PwndaThePwner/Hydration/Orders&Datasheets/readme

PCB component orders and associated datasheets
