PwndaThePwner/Hydration/documents/Inventory.xlsx

Sheet: Inventory
 | INVENTORY AS OF 2/26/2021
Type | Item# | Description | # | Additional Notes |  | # used b/w 3 PCBs
MCU | ATMEGA8U2-MURCT-ND | QFN package mcu | 1 | newest mcu ordered | *** | 1
 | 556-ATMEGA32U4-AU | 32kb flash avr mcu | 2 | PCBs designed for this |  | 1
 | A000053 | Arduino Micro | 1 | prototype board | ??? | 0
PCB | FEMAVitalsMonitor | Non-flexible | 3 | - |  | *
 | FEMAVitalsMonitor | Flexible | 3 | - |  | *
 | ImpedancePulseOximeter | Non-flexible | 3 | - |  | *
 | ImpedancePulseOximeter | Flexible | 3 | - |  | *
 | BodyTempSensor | Non-flexible | 3 | - |  | *
 | BodyTempSensor | Flexible | 2 | - |  | *
LoRa | 474-Com-13909 | LoRa Radio Wireless Transceiver | 3 | RF Modules RFM69HCW Wireless Transceiver - 915MHz |  | 1
Resistors | 667-ERA-6AED1471V | 0805 1.47k ohm resistor | 5 |  |  | 1
 | 667-ERJ-6RBD5101V | 0805 5.1k ohm resistor | 5 |  |  | 2
 | 71-RCS080522R0FKEA | 0805 22 ohm resistor | 5 |  |  | 1
 | 667-ERA-6VEB1001V | 0805 1k ohm resistor | 10 |  |  | 3
 | 652-CMP0805AFX-1002L | 10k ohm resistor | 10 |  |  | 3
 | 660-HV732ATTD754J | 750k ohm resistor | 5 |  |  | 1
 | 660-RK73H2ATTD1003D | 100k ohm resistor | 20 |  |  | 6
 | 603-RT0805FRE134K7L | 4.7k ohm resistor | 20 |  |  | 7
 | 660-RS73G2ATTD4992F | 49.9k ohm resistor | 10 |  |  | 4
 | 71-RCS0805300RJNEA | 300 ohm resistor | 5 |  |  | 1
 | 667-ERJ-12SF20R0U | 2010 20 ohm resistor | 5 |  |  | 1
 | 660-RN73R2ATD2002B25 | 20k ohm resistor | 5 |  |  | 2
Capacitors | 963-UMF212B7105KGHT | 0805 1uF capacitor | 15 |  |  | 5
 | 80-C0805C226K7PACTU | 0805 22uF capacitor | 5 |  |  | 1
 | 963-HMF212B7473KGHT | 0805 47nF capacitor | 5 |  |  | 1
 | 963-UMF212B7104KGHT | 0805 0.1uF capacitor | 30 |  |  | 14
 | 963-JMF212AB7106KGHT | 0805 10uF capacitor | 20 |  |  | 9
 | 810-FA16C0G2A104JRU6 | 0.1uF capacitor | 0 | empty bag |  | *
Inductors | 810-KLZ2012AHR2R2WTD | 2.2uH 10MHz 20% inductor | 4 |  |  | 2
 | 81-LQM21DH220M70L | 22uH 220mA inductor | 4 |  |  | *
Pulse Oximeter | SEN - 15219 | SparkFun Pulse Oximeter + HRS | 1 | contains max30101 & max32664 | *** | 0
 | MAX32664GTGB+ | MAX30101 Hub | 2 | chip alone |  | 1
 | 700-MAX30101EFD+ | Pulse Oximeter | 2 | EFD+ package |  | 1
 | MAX32664GTGA+ | MAX30101 Hub | 2 | chip alone | *** | 1
 | MAX30101EFD+TCT-ND | Integrated optical sensor | 1 |  |  | *
Diodes & Rectifiers | 833-SM5817PL-TP | Diode | 5 | Standard 20V 1A |  | 1
 | 863-MBR120LSFT3G | Diode | 5 | 20V 1A |  | 1
GPS | neo-m8n-0-10 | NEO-M8 series gps module | 1 |  | ***
 | 619-28504 | Parallax GPS modules | 1
Other | B00CHTO7EC | Tactile switches | 15 |  | ???? | ?
 | 579-MCP73831T-2ACIOT | Battery Management | 4 |  |  | 1
 | 584-AD8606ARMZ-R | AD8606 Op Amp | 4 |  |  | 1
 | 604-APTD2012LSURCK | 0805 Dome Lens LED | 5 |  |  | 1
 | 621-PAM2401SCADJ | Voltage regulator | 4 | 1.0MHz Step-Up |  | ?
 | 630-HSMC-C170-T0000 | Top Mt Red LED | 4 |  |  | 1
 | 611-SK50JSMTR92LFS | Tactile switches | 4 |  |  | ?
 | 712-CONUFL001-SMD-T | uFI Connector | 5 |  |  | 1
 | 815-ABS07W32.768KD1T | 32.768kHz 3pF crystal oscillator | 4 |  |  | 1
 | X000S3Z0SH | Electrode Pads | 9 | 4 2" x 2" connected pads w/ sensor strings
 | 579-24AA32AT-I/SN | EEPROM | 4 | memory |  | 1
 | 926-LP5951MG18NOPB | Voltage regulator | 4 | 150mA TI LDO |  | ?
 | 490-UJC-HP-G-SMT-TR | USB Connectors | 4 | CUI Devices |  | ? - ordered new ones
 | 262-BME280 | BME280 | 5 | Microchip temperature sensor |  | 1
 | 604-APTR3216SECK | Orange LED | 4 | Orange water clear |  | 1
 | C845-001 P758 | Jumper Cables | 12 | prototype
 | X000ZNOCW5 | 3.5mm plug | 1 | tens replacement
 | X001KGGWZ1 | M5Stack ESP32 development kit | 1 | 4615045 for prototyping
Analog Devices Inc. | AD5933YRSZ-REEL7CT-ND | impedance analyzer | 1 | 2 listed, 1 found in bag |  | 1
 | 584-ADG849YKSZ-R7 | analogue switches | 5
 | 584-5933WYRSZR | data acquisition ADCs/DACs | 2
Textiles | 200151011034HC | Conductive Twisted Yarn | 1 | 110/34 dtex 2 ply HC LR: < 3,000 ohm/m
 | 2601151022113 | Conductive Twisted Yarn | 1 | 22/1 dtex + 113/32 PET Ag Nylon + PET LR: < 30,000 ohm/m
 | 261151044113 | Conductive Twisted Yarn | 1 | 44/12 dtex + 113/32 PET Ag Nylon + PET LR: < 30,000 ohm/m
 | 20012107818 | Conductive Twisted Yarn | 1 | 78/18 dtex Zturns Ag Nylon LR: < 25,000 ohm/m
 | 200121235364HCB | Conductive Twisted Yarn | 1 | 235/36 dtex 4 ply HCB
 | 260151022110 | Conductive Twisted Yarn | 1 | 22/7 dtex + 110 PET 3 ply Ag Nylon + PET LR: < 200,000 kohm/m
 | 260121011717 | Conductive Twisted Yarn | 1 | 117/17 dtex 2 ply +B LR: < 3,000 ohm/m
 | 20012104412 | Conductive Twisted Yarn | 1 | 44/12 dtex Zturns Ag Nylon LR: < 10,000 ohm/m

Sheet: PCB Inv. Checks
PCB Inventory Checks |  |  |  |  |  |  | Color Legend
 |  |  |  |  |  |  |  | Not in inventory
 |  |  |  |  |  |  |  | Loose in tote
MCU (FemaVitalsMonitor.kicad_pcb) |  |  |  |  |  |  |  | in MCU box | Impedance Analysis Pulse Oximeter (ImpedanceRev1.0.kicad_pcb) |  |  |  |  |  |  |  | Body Temp Sensor (BodyTempSensor.kicad_pcb
 |  |  |  |  |  |  |  | Ordered
Type | Component | # Needed | # in Inv. | Location(s) |  | Conduct? |  |  | Type | Component | # Needed | # in Inv. | Location(s) |  | Conduct? |  | Type | Component | # Needed | # in Inv. | Location(s) | ***Solid and flex pcb both soldered
Resistors | 22 Ohm 2010 Resistor | 2 | 0 | R1, R2 | x | y |  |  | Resistor | 20 Ohm 2010 Resistor | 1 | 5 | R10 | x | y |  | Resistors | 4.7k Ohm Resistor | 2 | 20 | R1, R4 | x
 | 22 Ohm 0805 Resistor | 1 | 5 | R16 | x | y |  |  |  | 300 Ohm 0805 Resistor | 1 | 5 | R11 | x | y |  | Capacitors | 0.1uF 0805 Capacitor | 2 | 30 | C1, C2 | x
 | 1k Ohm 0805 Resistor | 3 | 10 | R6, R14, R15 | x | y |  |  |  | 4.7k Ohm 0805 Resistor | 3 | 20 | R12, R13, R16 | x | y |  | Modules | BME280 - Temp Sensor | 1 | 5 | U1 | x
 | 1.47k Ohm 0805 Resistor | 1 | 5 | R9 | x | y |  |  |  | 10k Ohm 0805 Resistor | 2 | 10 | R1, R2 | x | y |  | Misc | Conn01x04 | - | - | J1
 | 4.7k Ohm 0805 Resistor | 2 | 20 | R10, R11 | x | y |  |  |  | 20k Ohm 0805 Resistor | 2 | 5 | R3, R8 | x | y
 | 5.1k Ohm 0805 Resistor | 2 | 5 | R12, R13 | x | y |  |  |  | 49.9k Ohm 0805 Resistor | 4 | 10 | R4, R5, R6, R7 | x | y
 | 10k Ohm 0805 Resistor | 1 | 10 | R5 | x | y |  |  |  | 100k Ohm 0805 Resistor | 2 | 20 | R9, R14 | x | y
 | 100k Ohm 0805 Resistor | 4 | 20 | R3, R4, R7, R8 | x | y |  |  |  | 750k Ohm 0805 Resistor | 1 | 5 | R15 | x | y
Capacitors | 0.1 uF 0805 Capacitor | 1 | 30 | C8 | x | y |  |  | Capacitors | 0.1uF 0805 Capacitor | 10 | 30 | C3-C8, C10-C13 | x | y |  | Body Temp Sensor Components List - from Drive
 | 1 uF 0805 Capacitor | 2 | 15 | C1, C6 | x | y |  |  |  | 1 uF 0805 Capacitor | 3 | 15 | C18-C20 | x | y |  | Resistors
 | 10 uF 0805 Capacitor | 5 | 20 | C2, C3, C4, C5, C7 | x | y |  |  |  | 10 uF 0805 Capacitor | 4 | 20 | C1, C14, C16, C17 | x | y |  | Name | Value | Package
LEDs/Diodes | MBR120 1A 20V Diode | 1 | 5 | D1 | x |  |  |  |  | 22 uF 0805 Capacitor | 1 | 5 | C15 | x | y |  | R1 | 4.7k Ohms | Resistor_SMD:R_0805_2012Metric_Pad1.20x1.40mm_HandSolder
 | SM5817 1A 20V Diode | 1 | 5 | D3 | x |  |  |  |  | 47 nF 0805 Capacitor | 1 | 5 | C9 | x | y |  | R4 | 4.7k Ohms | Resistor_SMD:R_0805_2012Metric_Pad1.20x1.40mm_HandSolder
 | Orange LED - Pkg:1206 | 1 | 4 | D2 | x |  |  |  | Modules | AD5933 - Impedance Analyzer | 1 | 1 | U2 | x
 | Dome Lens LED 0805 | 1 | 5 | LED1 | x |  |  |  |  | ADG849 Switch | 2 | 5 | U3, U4 | x |  |  | Capacitors
 | AlInGaP Red LED 0805 | 1 | 4 | D4 | x |  |  |  |  | AD8606 - Op Amp | 1 | 4 | U5 | x |  |  | Name | Value | Package
Modules | ATmega32U4-MU | 1 | 0 | U1 | x |  |  |  |  | MAX30101EFD+ - Pulse Oximeter | 1 | 3 | U6 | x |  |  | C1 | 0.1 uF | Capacitor_SMD:C_0805_2012Metric_Pad1.18x1.45mm_HandSolder
 | RFM69HCW LoRa Transmitter | 1 | 2 | U3 | x |  |  |  |  | PAM2401 - Voltage Regulator | 1 | 4 | U7 | x |  |  | C2 | 0.1 uF | Capacitor_SMD:C_0805_2012Metric_Pad1.18x1.45mm_HandSolder
 | uFL Coaxial Connectors | 2 | 5 | U4, U8 | x |  |  |  |  | MAX32664GTGA+T - P. Ox. Hub | 1 | 2 | U8 | ~x
 | NEO-M8 | 1 | 1 | U6 | x |  |  |  |  | LP5951MG-1.8/NOPB - Voltage Regulator | 1 | 4 | U9 | x |  |  | Modules
 | MCP73831T Battery Management | 1 | 4 | U5 | x |  |  |  | Misc | ABS07W32 - Crystal Oscillator | 1 | 4 | Y1 | x |  | non-polarized | Name | Value | Package
 | AP2112K-3.3 Voltage Regulator | 1 | 0 | U2 |  |  |  |  |  |  |  |  |  |  |  |  | U1 | BME280 | BME280
 | 24AA32A - EEPROM | 1 | 4 | U7 | x |  |  |  |  | 2.2 uH 0805 Inductor | 1 | 4 | L1 | x |  | non-polarized?
Misc | USB Connnector | 1 | 4 | J3 | x |  |  |  |  |  |  |  |  |  |  | changes dir. Of mag. Field | Misc
 | Switches | 1 | Many | SW1 | x |  |  |  |  |  |  |  |  |  |  |  | Name | Value | Package
 | 2.2 uH 0805 Inductor | 1 | 4 | L1 | x |  |  |  |  |  |  |  |  |  |  |  | J1 | Conn_01x04 | Connector_PinHeader_2.54mm:PinHeader_1x04_P2.54mm_Vertical
 | AS13AH Switch | 0 | 0 | S1
 | 8.0 MHz Resonator | 1 | 0 | Y1 | x
 |  |  |  |  |  |  |  |  | Impedance Analysis Pulse Oximeter Components List - from Drive
 | MCU PCB (FEMAVitalsMonitor.kicad_pcb) Components List - from Drive |  |  |  |  |  |  |  | Resistors
 | Resistors |  |  |  |  |  |  |  | Name | Value | Package
 | Name | Value | Package |  |  |  |  |  | R1 | 10k Ohms | Resistor_SMD:R_0805_2012Metric_Pad1.20x1.40mm_HandSolder
 | R1 | 22 Ohms | Resistor_SMD:R_2010_5025Metric_Pad1.40x2.65mm_HandSolder |  |  |  |  |  | R2 | 10k Ohms | Resistor_SMD:R_0805_2012Metric_Pad1.20x1.40mm_HandSolder
 | R2 | 22 Ohms | Resistor_SMD:R_2010_5025Metric_Pad1.40x2.65mm_HandSolder |  |  |  |  |  | R3 | 20k Ohms | Resistor_SMD:R_0805_2012Metric_Pad1.20x1.40mm_HandSolder
 | R3 | 100k Ohms | Resistor_SMD:R_0805_2012Metric_Pad1.20x1.40mm_HandSolder |  |  |  |  |  | R4 | 49.9k Ohms | Resistor_SMD:R_0805_2012Metric_Pad1.20x1.40mm_HandSolder
 | R4 | 100k Ohms | Resistor_SMD:R_0805_2012Metric_Pad1.20x1.40mm_HandSolder |  |  |  |  |  | R5 | 49.9k Ohms | Resistor_SMD:R_0805_2012Metric_Pad1.20x1.40mm_HandSolder
 | R5 | 10k Ohms | Resistor_SMD:R_0805_2012Metric_Pad1.20x1.40mm_HandSolder |  |  |  |  |  | R6 | 49.9k Ohms | Resistor_SMD:R_0805_2012Metric_Pad1.20x1.40mm_HandSolder
 | R6 | 1k Ohms | Resistor_SMD:R_0805_2012Metric_Pad1.20x1.40mm_HandSolder |  |  |  |  |  | R7 | 49.9k Ohms | Resistor_SMD:R_0805_2012Metric_Pad1.20x1.40mm_HandSolder
 | R7 | 100k Ohms | Resistor_SMD:R_0805_2012Metric_Pad1.20x1.40mm_HandSolder |  |  |  |  |  | R8 | 20k Ohms | Resistor_SMD:R_0805_2012Metric_Pad1.20x1.40mm_HandSolder
 | R8 | 100k Ohms | Resistor_SMD:R_0805_2012Metric_Pad1.20x1.40mm_HandSolder |  |  |  |  |  | R9 | 100k Ohms | Resistor_SMD:R_0805_2012Metric_Pad1.20x1.40mm_HandSolder
 | R9 | 1.47k Ohms | Resistor_SMD:R_0805_2012Metric_Pad1.20x1.40mm_HandSolder |  |  |  |  |  | R10 | 20 Ohms | Resistor_SMD:R_2010_5025Metric_Pad1.40x2.65mm_HandSolder
 | R10 | 4.7k Ohms | Resistor_SMD:R_0805_2012Metric_Pad1.20x1.40mm_HandSolder |  |  |  |  |  | R11 | 300 Ohms | Resistor_SMD:R_0805_2012Metric_Pad1.20x1.40mm_HandSolder
 | R11 | 4.7k Ohms | Resistor_SMD:R_0805_2012Metric_Pad1.20x1.40mm_HandSolder |  |  |  |  |  | R12 | 4.7k Ohms | Resistor_SMD:R_0805_2012Metric_Pad1.20x1.40mm_HandSolder
 | R12 | 5.1k Ohms | Resistor_SMD:R_0805_2012Metric_Pad1.20x1.40mm_HandSolder |  |  |  |  |  | R13 | 4.7k Ohms | Resistor_SMD:R_0805_2012Metric_Pad1.20x1.40mm_HandSolder
 | R13 | 5.1k Ohms | Resistor_SMD:R_0805_2012Metric_Pad1.20x1.40mm_HandSolder |  |  |  |  |  | R14 | 100k Ohms | Resistor_SMD:R_0805_2012Metric_Pad1.20x1.40mm_HandSolder
 | R14 | 1k Ohms | Resistor_SMD:R_0805_2012Metric_Pad1.20x1.40mm_HandSolder |  |  |  |  |  | R15 | 750k Ohms | Resistor_SMD:R_0805_2012Metric_Pad1.20x1.40mm_HandSolder
 | R15 | 1k Ohms | Resistor_SMD:R_0805_2012Metric_Pad1.20x1.40mm_HandSolder |  |  |  |  |  | R16 | 4.7k Ohms | Resistor_SMD:R_0805_2012Metric_Pad1.20x1.40mm_HandSolder
 | R16 | 22 Ohms | Resistor_SMD:R_0805_2012Metric_Pad1.20x1.40mm_HandSolder
 |  |  |  |  |  |  |  |  | Capacitors
 | Capacitors |  |  |  |  |  |  |  | Name | Value | Packages
 | Name | Value | Package |  |  |  |  |  | C1 | 10 uF | Capacitor_SMD:C_0805_2012Metric_Pad1.18x1.45mm_HandSolder
 | C1 | 1 uF | Capacitor_SMD:C_0805_2012Metric_Pad1.18x1.45mm_HandSolder |  |  |  |  |  | C3 | 0.1 uF | Capacitor_SMD:C_0805_2012Metric_Pad1.18x1.45mm_HandSolder
 | C2 | 10 uF | Capacitor_SMD:C_0805_2012Metric_Pad1.18x1.45mm_HandSolder |  |  |  |  |  | C4 | 0.1 uF | Capacitor_SMD:C_0805_2012Metric_Pad1.18x1.45mm_HandSolder
 | C3 | 10 uF | Capacitor_SMD:C_0805_2012Metric_Pad1.18x1.45mm_HandSolder |  |  |  |  |  | C5 | 0.1 uF | Capacitor_SMD:C_0805_2012Metric_Pad1.18x1.45mm_HandSolder
 | C4 | 10 uF | Capacitor_SMD:C_0805_2012Metric_Pad1.18x1.45mm_HandSolder |  |  |  |  |  | C6 | 0.1 uF | Capacitor_SMD:C_0805_2012Metric_Pad1.18x1.45mm_HandSolder
 | C5 | 10 uF | Capacitor_SMD:C_0805_2012Metric_Pad1.18x1.45mm_HandSolder |  |  |  |  |  | C7 | 0.1 uF | Capacitor_SMD:C_0805_2012Metric_Pad1.18x1.45mm_HandSolder
 | C6 | 1 uF | Capacitor_SMD:C_0805_2012Metric_Pad1.18x1.45mm_HandSolder |  |  |  |  |  | C8 | 0.1 uF | Capacitor_SMD:C_0805_2012Metric_Pad1.18x1.45mm_HandSolder
 | C7 | 10 uF | Capacitor_SMD:C_0805_2012Metric_Pad1.18x1.45mm_HandSolder |  |  |  |  |  | C9 | 47 nF | Capacitor_SMD:C_0805_2012Metric_Pad1.18x1.45mm_HandSolder
 | C8 | 0.1 uF | Capacitor_SMD:C_0805_2012Metric_Pad1.18x1.45mm_HandSolder |  |  |  |  |  | C10 | 0.1 uF | Capacitor_SMD:C_0805_2012Metric_Pad1.18x1.45mm_HandSolder
 |  |  |  |  |  |  |  |  | C11 | 0.1 uF | Capacitor_SMD:C_0805_2012Metric_Pad1.18x1.45mm_HandSolder
 | Diodes |  |  |  |  |  |  |  | C12 | 0.1 uF | Capacitor_SMD:C_0805_2012Metric_Pad1.18x1.45mm_HandSolder
 | Name | Value | Package |  |  |  |  |  | C13 | 0.1 uF | Capacitor_SMD:C_0805_2012Metric_Pad1.18x1.45mm_HandSolder
 | D1 | MBR120 | Diode_SMD:D_SOD-123F |  |  |  |  |  | C14 | 10 uF | Capacitor_SMD:C_0805_2012Metric_Pad1.18x1.45mm_HandSolder
 | D2 | LED | LED_SMD:LED_1206_3216Metric_Pad1.42x1.75mm_HandSolder |  |  |  |  |  | C15 | 22 uF | Capacitor_SMD:C_0805_2012Metric_Pad1.18x1.45mm_HandSolder
 | D3 | SM5817PL-TP | SOD3716X120N |  |  |  |  |  | C16 | 10 uF | Capacitor_SMD:C_0805_2012Metric_Pad1.18x1.45mm_HandSolder
 | D4 | FIX | LED_SMD:LED_0805_2012Metric_Pad1.15x1.40mm_HandSolder |  |  |  |  |  | C17 | 10 uF | Capacitor_SMD:C_0805_2012Metric_Pad1.18x1.45mm_HandSolder
 | LED1 | APTD2012LSURCK | LEDM2012X120N |  |  |  |  |  | C18 | 1.0 uF | Capacitor_SMD:C_0805_2012Metric_Pad1.18x1.45mm_HandSolder
 |  |  |  |  |  |  |  |  | C19 | 1.0 uF | Capacitor_SMD:C_0805_2012Metric_Pad1.18x1.45mm_HandSolder
 | Modules |  |  |  |  |  |  |  | C20 | 1.0 uF | Capacitor_SMD:C_0805_2012Metric_Pad1.18x1.45mm_HandSolder
 | Name | Value | Package
 | U1 | ATmega32U4-MU | Package_DFN_QFN:QFN-44-1EP_7x7mm_P0.5mm_EP5.2x5.2mm |  |  |  |  |  | Modules
 | U2 | AP2112K-3.3 | Package_TO_SOT_SMD:SOT-23-5 |  |  |  |  |  | Name | Value | Packages
 | U3 | RFM69HCW | RFM69HCW |  |  |  |  |  | U2 | AD5933 | Package_SO:SSOP-16_5.3x6.2mm_P0.65mm
 | U4 | uFL | Connector_Coaxial:U.FL_Hirose_U.FL-R-SMT-1_Vertical |  |  |  |  |  | U3 | ADG849 | ADG849
 | U5 | MCP73831-2-OT | Package_TO_SOT_SMD:SOT-23-5 |  |  |  |  |  | U4 | ADG849 | ADG849
 | U6 | NEO-M8 | NEO-M8 |  |  |  |  |  | U5 | AD8606 | Package_SO:MSOP-8_3x3mm_P0.65mm
 | U7 | 24AA32A | Package_SO:SOIJ-8_5.3x5.3mm_P1.27mm |  |  |  |  |  | U6 | MAX30101EFD | SamacSys_Parts:14-LEAD-OESIP
 | U8 | uFL | Connector_Coaxial:U.FL_Hirose_U.FL-R-SMT-1_Vertical |  |  |  |  |  | U7 | PAM2401 | Package_SO:MSOP-8_3x3mm_P0.65mm
 |  |  |  |  |  |  |  |  | U8 | MAX32664GTGA+T | MAX32664GTGA+T
 | Misc |  |  |  |  |  |  |  | U9 | LP5951MG-1.8/NOPB | Package_TO_SOT_SMD:SOT-353_SC-70-5_Handsoldering
 | Name | Value | Package
 | J1 | Battery | Connector_PinHeader_2.54mm:PinHeader_1x02_P2.54mm_Vertical |  |  |  |  |  | Misc
 | J2 | Conn_01x08 | Connector_PinHeader_2.54mm:PinHeader_1x08_P2.54mm_Vertical |  |  |  |  |  | Name | Value | Packages
 | J3 | USB_C_Receptacle_USB2.0 | Connector_USB:USB_C_Receptacle_GCT_USB4085 |  |  |  |  |  | J1 | Conn_01x08 | Connector_PinHeader_2.54mm:PinHeader_1x08_P2.54mm_Vertical
 | Y1 | 8MHz | SamacSys_Parts:AWSCR800CELBC10T3 |  |  |  |  |  | J2 | Electrode + | Connector_PinHeader_2.54mm:PinHeader_1x02_P2.54mm_Vertical
 | SW1 | SW_DIP_x01 | Button_Switch_THT:SW_PUSH_6mm_H7.3mm |  |  |  |  |  | J3 | Electrode - | Connector_PinHeader_2.54mm:PinHeader_1x02_P2.54mm_Vertical
 | S1 | AS11AH | AS11AH |  |  |  |  |  | Y1 | ABS07W-32.768kHz-D-1-T | ABS07AIG32768kHz71T
 | L1 | 22 uH | Inductor_SMD:L_0805_2012Metric_Pad1.15x1.40mm_HandSolder |  |  |  |  |  | L1 | 2.2 uH | Inductor_SMD:L_0805_2012Metric_Pad1.15x1.40mm_HandSolder

Sheet: 4-28 Inv. Etc.
Item | Quantity
FVM Rigid PCB | 3
IAPO Rigid PCB | 3
BTS Rigid PCB | 2
BTS Rigid PCB (assembled) | 1
FVM Flex PCB | 2
FVM Flex PCB (in progress) | 1
IAPO Flex PCB | 2
IAPO Flex PCB (assembled) | 1
BTS Flex PCB | 1
BTS Flex PCB (assembled) | 1

Sheet: 4-28 PCB Inv.
PCB Inventory Checks |  |  |  |  |  | Color Legend
 |  |  |  |  |  |  | Ordered
 |  |  |  |  |  |  | Not in inventory
FVM (FemaVitalsMonitor.kicad_pcb) |  |  |  |  |  |  |  | IAPO (ImpedanceRev1.0.kicad_pcb) |  |  |  |  | BTS (BodyTempSensor.kicad_pcb
Type | Component | # Needed | # in Inv. | Location(s) |  |  |  | Type | Component | # Needed | # in Inv. | Location(s) | Type | Component | # Needed | # in Inv. | Location(s)
Resistors | 22 Ohm 2010 Resistor | 2 | 3 | R1, R2 | x |  |  | Resistor | 20 Ohm 2010 Resistor | 1 | 4 | R10 | Resistors | 4.7k Ohm Resistor | 2 | 11 | R1, R4
 | 22 Ohm 0805 Resistor | 1 | 4 | R16 | x |  |  |  | 300 Ohm 0805 Resistor | 1 | 4 | R11 | Capacitors | 0.1uF 0805 Capacitor | 2 | 14 | C1, C2
 | 1k Ohm 0805 Resistor | 3 | 7 | R6, R14, R15 | x |  |  |  | 4.7k Ohm 0805 Resistor | 3 | 11 | R12, R13, R16 | Modules | BME280 - Temp Sensor | 1 | 3 | U1
 | 1.47k Ohm 0805 Resistor | 1 | 4 | R9 | x |  |  |  | 10k Ohm 0805 Resistor | 2 | 7 | R1, R2 | Misc | Conn01x04 | - | - | J1
 | 4.7k Ohm 0805 Resistor | 2 | 11 | R10, R11 | x |  |  |  | 20k Ohm 0805 Resistor | 2 | 3 | R3, R8
 | 5.1k Ohm 0805 Resistor | 2 | 3 | R12, R13 | x |  |  |  | 49.9k Ohm 0805 Resistor | 4 | 5 | R4, R5, R6, R7
 | 10k Ohm 0805 Resistor | 1 | 7 | R5 | x |  |  |  | 100k Ohm 0805 Resistor | 2 | 12 | R9, R14
 | 100k Ohm 0805 Resistor | 4 | 12 | R3, R4, R7, R8 | x |  |  |  | 750k Ohm 0805 Resistor | 1 | 4 | R15
Capacitors | 0.1 uF 0805 Capacitor | 1 | 14 | C8 | X |  |  | Capacitors | 0.1uF 0805 Capacitor | 10 | 14 | C3-C8, C10-C13 | Body Temp Sensor Components List - from Drive
 | 1 uF 0805 Capacitor | 2 | 9 | C1, C6 | x |  |  |  | 1 uF 0805 Capacitor | 3 | 9 | C18-C20 | Resistors
 | 10 uF 0805 Capacitor | 5 | 11 | C2, C3, C4, C5, C7 | x |  |  |  | 10 uF 0805 Capacitor | 4 | 11 | C1, C14, C16, C17 | Name | Value | Package
LEDs/Diodes | MBR120 1A 20V Diode | 1 | 4 | D1 | X |  |  |  | 22 uF 0805 Capacitor | 1 | 4 | C15 | R1 | 4.7k Ohms | Resistor_SMD:R_0805_2012Metric_Pad1.20x1.40mm_HandSolder
 | SM5817 1A 20V Diode | 1 | 4 | D3 |  |  |  |  | 47 nF 0805 Capacitor | 1 | 4 | C9 | R4 | 4.7k Ohms | Resistor_SMD:R_0805_2012Metric_Pad1.20x1.40mm_HandSolder
 | Orange LED - Pkg:1206 | 1 | 3 | D2 | X |  |  | Modules | AD5933 - Impedance Analyzer | 1 | 2 | U2
 | Dome Lens LED 0805 | 1 | 4 | LED1 |  |  |  |  | ADG849 Switch | 2 | 1 | U3, U4 | Capacitors
 | AlInGaP Red LED 0805 | 1 | 3 | D4 |  |  |  |  | AD8606 - Op Amp | 1 | 2 | U5 | Name | Value | Package
Modules | ATmega32U4-MU | 1 | 2 | U1 |  |  |  |  | MAX30101EFD+ - Pulse Oximeter | 1 | 0 | U6 | C1 | 0.1 uF | Capacitor_SMD:C_0805_2012Metric_Pad1.18x1.45mm_HandSolder
 | RFM69HCW LoRa Transmitter | 1 | 3 | U3 | x |  |  |  | PAM2401 - Voltage Regulator | 1 | 4 | U7 | C2 | 0.1 uF | Capacitor_SMD:C_0805_2012Metric_Pad1.18x1.45mm_HandSolder
 | uFL Coaxial Connectors | 2 | 3 | U4, U8 | x |  |  |  | MAX32664GTGA+T - P. Ox. Hub | 1 | 1 | U8
 | NEO-M8 | 1 | 0 | U6 |  |  |  |  | LP5951MG-1.8/NOPB - Voltage Regulator | 1 | 3 | U9 | Modules
 | MCP73831T Battery Management | 1 | 3 | U5 |  |  |  | Misc | ABS07W32 - Crystal Oscillator | 1 | 3 | Y1 | Name | Value | Package
 | AP2112K-3.3 Voltage Regulator | 1 | 0 | U2 |  |  |  |  |  |  |  |  | U1 | BME280 | BME280
 | 24AA32A - EEPROM | 1 | 3 | U7 |  |  |  |  | 2.2 uH 0805 Inductor | 1 | 1 | L1
Misc | USB Connnector | 1 | 2 | J3 |  |  |  |  |  |  |  |  | Misc
 | Switches | 1 | Many | SW1 |  |  |  |  |  |  |  |  | Name | Value | Package
 | 2.2 uH 0805 Inductor | 1 | 1 | L1 | x |  |  |  |  |  |  |  | J1 | Conn_01x04 | Connector_PinHeader_2.54mm:PinHeader_1x04_P2.54mm_Vertical
 | AS11AH Switch | 1 | 2 | S1
 | 8.0 MHz Resonator | 1 | 4 | Y1 | x
 |  |  |  |  |  |  |  | Impedance Analysis Pulse Oximeter Components List - from Drive
 | MCU PCB (FEMAVitalsMonitor.kicad_pcb) Components List - from Drive |  |  |  |  |  |  | Resistors
 | Resistors |  |  |  |  |  |  | Name | Value | Package
 | Name | Value | Package |  |  |  |  | R1 | 10k Ohms | Resistor_SMD:R_0805_2012Metric_Pad1.20x1.40mm_HandSolder
 | R1 | 22 Ohms | Resistor_SMD:R_2010_5025Metric_Pad1.40x2.65mm_HandSolder |  |  |  |  | R2 | 10k Ohms | Resistor_SMD:R_0805_2012Metric_Pad1.20x1.40mm_HandSolder
 | R2 | 22 Ohms | Resistor_SMD:R_2010_5025Metric_Pad1.40x2.65mm_HandSolder |  |  |  |  | R3 | 20k Ohms | Resistor_SMD:R_0805_2012Metric_Pad1.20x1.40mm_HandSolder
 | R3 | 100k Ohms | Resistor_SMD:R_0805_2012Metric_Pad1.20x1.40mm_HandSolder |  |  |  |  | R4 | 49.9k Ohms | Resistor_SMD:R_0805_2012Metric_Pad1.20x1.40mm_HandSolder
 | R4 | 100k Ohms | Resistor_SMD:R_0805_2012Metric_Pad1.20x1.40mm_HandSolder |  |  |  |  | R5 | 49.9k Ohms | Resistor_SMD:R_0805_2012Metric_Pad1.20x1.40mm_HandSolder
 | R5 | 10k Ohms | Resistor_SMD:R_0805_2012Metric_Pad1.20x1.40mm_HandSolder |  |  |  |  | R6 | 49.9k Ohms | Resistor_SMD:R_0805_2012Metric_Pad1.20x1.40mm_HandSolder
 | R6 | 1k Ohms | Resistor_SMD:R_0805_2012Metric_Pad1.20x1.40mm_HandSolder |  |  |  |  | R7 | 49.9k Ohms | Resistor_SMD:R_0805_2012Metric_Pad1.20x1.40mm_HandSolder
 | R7 | 100k Ohms | Resistor_SMD:R_0805_2012Metric_Pad1.20x1.40mm_HandSolder |  |  |  |  | R8 | 20k Ohms | Resistor_SMD:R_0805_2012Metric_Pad1.20x1.40mm_HandSolder
 | R8 | 100k Ohms | Resistor_SMD:R_0805_2012Metric_Pad1.20x1.40mm_HandSolder |  |  |  |  | R9 | 100k Ohms | Resistor_SMD:R_0805_2012Metric_Pad1.20x1.40mm_HandSolder
 | R9 | 1.47k Ohms | Resistor_SMD:R_0805_2012Metric_Pad1.20x1.40mm_HandSolder |  |  |  |  | R10 | 20 Ohms | Resistor_SMD:R_2010_5025Metric_Pad1.40x2.65mm_HandSolder
 | R10 | 4.7k Ohms | Resistor_SMD:R_0805_2012Metric_Pad1.20x1.40mm_HandSolder |  |  |  |  | R11 | 300 Ohms | Resistor_SMD:R_0805_2012Metric_Pad1.20x1.40mm_HandSolder
 | R11 | 4.7k Ohms | Resistor_SMD:R_0805_2012Metric_Pad1.20x1.40mm_HandSolder |  |  |  |  | R12 | 4.7k Ohms | Resistor_SMD:R_0805_2012Metric_Pad1.20x1.40mm_HandSolder
 | R12 | 5.1k Ohms | Resistor_SMD:R_0805_2012Metric_Pad1.20x1.40mm_HandSolder |  |  |  |  | R13 | 4.7k Ohms | Resistor_SMD:R_0805_2012Metric_Pad1.20x1.40mm_HandSolder
 | R13 | 5.1k Ohms | Resistor_SMD:R_0805_2012Metric_Pad1.20x1.40mm_HandSolder |  |  |  |  | R14 | 100k Ohms | Resistor_SMD:R_0805_2012Metric_Pad1.20x1.40mm_HandSolder
 | R14 | 1k Ohms | Resistor_SMD:R_0805_2012Metric_Pad1.20x1.40mm_HandSolder |  |  |  |  | R15 | 750k Ohms | Resistor_SMD:R_0805_2012Metric_Pad1.20x1.40mm_HandSolder
 | R15 | 1k Ohms | Resistor_SMD:R_0805_2012Metric_Pad1.20x1.40mm_HandSolder |  |  |  |  | R16 | 4.7k Ohms | Resistor_SMD:R_0805_2012Metric_Pad1.20x1.40mm_HandSolder
 | R16 | 22 Ohms | Resistor_SMD:R_0805_2012Metric_Pad1.20x1.40mm_HandSolder
 |  |  |  |  |  |  |  | Capacitors
 | Capacitors |  |  |  |  |  |  | Name | Value | Packages
 | Name | Value | Package |  |  |  |  | C1 | 10 uF | Capacitor_SMD:C_0805_2012Metric_Pad1.18x1.45mm_HandSolder
 | C1 | 1 uF | Capacitor_SMD:C_0805_2012Metric_Pad1.18x1.45mm_HandSolder |  |  |  |  | C3 | 0.1 uF | Capacitor_SMD:C_0805_2012Metric_Pad1.18x1.45mm_HandSolder
 | C2 | 10 uF | Capacitor_SMD:C_0805_2012Metric_Pad1.18x1.45mm_HandSolder |  |  |  |  | C4 | 0.1 uF | Capacitor_SMD:C_0805_2012Metric_Pad1.18x1.45mm_HandSolder
 | C3 | 10 uF | Capacitor_SMD:C_0805_2012Metric_Pad1.18x1.45mm_HandSolder |  |  |  |  | C5 | 0.1 uF | Capacitor_SMD:C_0805_2012Metric_Pad1.18x1.45mm_HandSolder
 | C4 | 10 uF | Capacitor_SMD:C_0805_2012Metric_Pad1.18x1.45mm_HandSolder |  |  |  |  | C6 | 0.1 uF | Capacitor_SMD:C_0805_2012Metric_Pad1.18x1.45mm_HandSolder
 | C5 | 10 uF | Capacitor_SMD:C_0805_2012Metric_Pad1.18x1.45mm_HandSolder |  |  |  |  | C7 | 0.1 uF | Capacitor_SMD:C_0805_2012Metric_Pad1.18x1.45mm_HandSolder
 | C6 | 1 uF | Capacitor_SMD:C_0805_2012Metric_Pad1.18x1.45mm_HandSolder |  |  |  |  | C8 | 0.1 uF | Capacitor_SMD:C_0805_2012Metric_Pad1.18x1.45mm_HandSolder
 | C7 | 10 uF | Capacitor_SMD:C_0805_2012Metric_Pad1.18x1.45mm_HandSolder |  |  |  |  | C9 | 47 nF | Capacitor_SMD:C_0805_2012Metric_Pad1.18x1.45mm_HandSolder
 | C8 | 0.1 uF | Capacitor_SMD:C_0805_2012Metric_Pad1.18x1.45mm_HandSolder |  |  |  |  | C10 | 0.1 uF | Capacitor_SMD:C_0805_2012Metric_Pad1.18x1.45mm_HandSolder
 |  |  |  |  |  |  |  | C11 | 0.1 uF | Capacitor_SMD:C_0805_2012Metric_Pad1.18x1.45mm_HandSolder
 | Diodes |  |  |  |  |  |  | C12 | 0.1 uF | Capacitor_SMD:C_0805_2012Metric_Pad1.18x1.45mm_HandSolder
 | Name | Value | Package |  |  |  |  | C13 | 0.1 uF | Capacitor_SMD:C_0805_2012Metric_Pad1.18x1.45mm_HandSolder
 | D1 | MBR120 | Diode_SMD:D_SOD-123F |  |  |  |  | C14 | 10 uF | Capacitor_SMD:C_0805_2012Metric_Pad1.18x1.45mm_HandSolder
 | D2 | LED | LED_SMD:LED_1206_3216Metric_Pad1.42x1.75mm_HandSolder |  |  |  |  | C15 | 22 uF | Capacitor_SMD:C_0805_2012Metric_Pad1.18x1.45mm_HandSolder
 | D3 | SM5817PL-TP | SOD3716X120N |  |  |  |  | C16 | 10 uF | Capacitor_SMD:C_0805_2012Metric_Pad1.18x1.45mm_HandSolder
 | D4 | FIX | LED_SMD:LED_0805_2012Metric_Pad1.15x1.40mm_HandSolder |  |  |  |  | C17 | 10 uF | Capacitor_SMD:C_0805_2012Metric_Pad1.18x1.45mm_HandSolder
 | LED1 | APTD2012LSURCK | LEDM2012X120N |  |  |  |  | C18 | 1.0 uF | Capacitor_SMD:C_0805_2012Metric_Pad1.18x1.45mm_HandSolder
 |  |  |  |  |  |  |  | C19 | 1.0 uF | Capacitor_SMD:C_0805_2012Metric_Pad1.18x1.45mm_HandSolder
 | Modules |  |  |  |  |  |  | C20 | 1.0 uF | Capacitor_SMD:C_0805_2012Metric_Pad1.18x1.45mm_HandSolder
 | Name | Value | Package
 | U1 | ATmega32U4-MU | Package_DFN_QFN:QFN-44-1EP_7x7mm_P0.5mm_EP5.2x5.2mm |  |  |  |  | Modules
 | U2 | AP2112K-3.3 | Package_TO_SOT_SMD:SOT-23-5 |  |  |  |  | Name | Value | Packages
 | U3 | RFM69HCW | RFM69HCW |  |  |  |  | U2 | AD5933 | Package_SO:SSOP-16_5.3x6.2mm_P0.65mm
 | U4 | uFL | Connector_Coaxial:U.FL_Hirose_U.FL-R-SMT-1_Vertical |  |  |  |  | U3 | ADG849 | ADG849
 | U5 | MCP73831-2-OT | Package_TO_SOT_SMD:SOT-23-5 |  |  |  |  | U4 | ADG849 | ADG849
 | U6 | NEO-M8 | NEO-M8 |  |  |  |  | U5 | AD8606 | Package_SO:MSOP-8_3x3mm_P0.65mm
 | U7 | 24AA32A | Package_SO:SOIJ-8_5.3x5.3mm_P1.27mm |  |  |  |  | U6 | MAX30101EFD | SamacSys_Parts:14-LEAD-OESIP
 | U8 | uFL | Connector_Coaxial:U.FL_Hirose_U.FL-R-SMT-1_Vertical |  |  |  |  | U7 | PAM2401 | Package_SO:MSOP-8_3x3mm_P0.65mm
 |  |  |  |  |  |  |  | U8 | MAX32664GTGA+T | MAX32664GTGA+T
 | Misc |  |  |  |  |  |  | U9 | LP5951MG-1.8/NOPB | Package_TO_SOT_SMD:SOT-353_SC-70-5_Handsoldering
 | Name | Value | Package
 | J1 | Battery | Connector_PinHeader_2.54mm:PinHeader_1x02_P2.54mm_Vertical |  |  |  |  | Misc
 | J2 | Conn_01x08 | Connector_PinHeader_2.54mm:PinHeader_1x08_P2.54mm_Vertical |  |  |  |  | Name | Value | Packages
 | J3 | USB_C_Receptacle_USB2.0 | Connector_USB:USB_C_Receptacle_GCT_USB4085 |  |  |  |  | J1 | Conn_01x08 | Connector_PinHeader_2.54mm:PinHeader_1x08_P2.54mm_Vertical
 | Y1 | 8MHz | SamacSys_Parts:AWSCR800CELBC10T3 |  |  |  |  | J2 | Electrode + | Connector_PinHeader_2.54mm:PinHeader_1x02_P2.54mm_Vertical
 | SW1 | SW_DIP_x01 | Button_Switch_THT:SW_PUSH_6mm_H7.3mm |  |  |  |  | J3 | Electrode - | Connector_PinHeader_2.54mm:PinHeader_1x02_P2.54mm_Vertical
 | S1 | AS11AH | AS11AH |  |  |  |  | Y1 | ABS07W-32.768kHz-D-1-T | ABS07AIG32768kHz71T
 | L1 | 22 uH | Inductor_SMD:L_0805_2012Metric_Pad1.15x1.40mm_HandSolder |  |  |  |  | L1 | 2.2 uH | Inductor_SMD:L_0805_2012Metric_Pad1.15x1.40mm_HandSolder

Sheet: 4-30 Order Count
Item | FVM | IAPO | BTS | # Needed/Assembled System | Total Needed for 3 systems | # Needed for first system | # in Inv. (4/30) | # to order (4/30)
Resistors
20 Ohm 2010 Resistor | 0 | 1 | 0 | 1 | 3 | 0 | 4 | 2
22 Ohm 2010 Resistor | 2 | 0 | 0 | 2 | 6 | 0 | 3 | 6
22 Ohm 0805 Resistor | 1 | 0 | 0 | 1 | 3 | 0 | 4 | 2
300 Ohm 0805 Resistor | 0 | 1 | 0 | 1 | 3 | 0 | 4 | 2
1k Ohm 0805 Resistor | 3 | 0 | 0 | 3 | 9 | 0 | 7 | 5
1.47k Ohm 0805 Resistor | 1 | 0 | 0 | 1 | 3 | 0 | 4 | 2
4.7k Ohm 0805 Resistor | 2 | 3 | 2 | 7 | 21 | 0 | 11 | 13
5.1k Ohm 0805 Resistor | 2 | 0 | 0 | 2 | 6 | 0 | 3 | 6
10k Ohm 0805 Resistor | 1 | 2 | 0 | 3 | 9 | 0 | 7 | 5
20k Ohm 0805 Resistor | 0 | 2 | 0 | 2 | 6 | 0 | 3 | 6
49.9k Ohm 0805 Resistor | 0 | 4 | 0 | 4 | 12 | 0 | 5 | 10
100k Ohm 0805 Resistor | 4 | 2 | 0 | 6 | 18 | 0 | 12 | 9
750k Ohm 0805 Resistor | 0 | 1 | 0 | 1 | 3 | 0 | 4 | 2
Capacitors
0.1uF 0805 Capacitor | 1 | 10 | 2 | 13 | 39 | 0 | 14 | 28
1 uF 0805 Capacitor | 2 | 3 | 0 | 5 | 15 | 0 | 9 | 9
10 uF 0805 Capacitor | 5 | 4 | 0 | 9 | 27 | 0 | 11 | 19
22 uF 0805 Capacitor | 0 | 1 | 0 | 1 | 3 | 0 | 4 | 2
47 nF 0805 Capacitor | 0 | 1 | 0 | 1 | 3 | 0 | 4 | 2
LEDs/Diodes
MBR120 1A 20V Diode | 1 | 0 | 0 | 1 | 3 | 0 | 4 | 2
SM5817 1A 20V Diode | 1 | 0 | 0 | 1 | 3 | 0 | 4 | 2
Orange LED - Pkg:1206 | 1 | 0 | 0 | 1 | 3 | 0 | 3 | 3
Dome Lens LED 0805 | 1 | 0 | 0 | 1 | 3 | 0 | 4 | 2
AlInGaP Red LED 0805 | 1 | 0 | 0 | 1 | 3 | 0 | 3 | 3
Modules
ATmega32U4-MU | 1 | 0 | 0 | 1 | 3 | 0 | 2 | 4
RFM69HCW LoRa Transmitter | 1 | 0 | 0 | 1 | 3 | 1 | 0 | 7
uFL Coaxial Connectors | 2 | 0 | 0 | 2 | 6 | 0 | 3 | 6
NEO-M8 | 1 | 0 | 0 | 1 | 3 | 1 | 0 | 7
MCP73831T Battery Management | 1 | 0 | 0 | 1 | 3 | 0 | 3 | 3
AP2112K-3.3 Voltage Regulator | 1 | 0 | 0 | 1 | 3 | 0 | 0 | 6
24AA32A - EEPROM | 1 | 0 | 0 | 1 | 3 | 0 | 3 | 3
AD5933 - Impedance Analyzer | 0 | 1 | 0 | 1 | 3 | 0 | 2 | 4
ADG849 Switch | 0 | 2 | 0 | 2 | 6 | 0 | 1 | 8
AD8606 - Op Amp | 0 | 1 | 0 | 1 | 3 | 0 | 2 | 4
MAX30101EFD+ - Pulse Oximeter | 0 | 1 | 0 | 1 | 3 | 1 | 0 | 7
PAM2401 - Voltage Regulator | 0 | 1 | 0 | 1 | 3 | 0 | 4 | 2
MAX32664GTGA+T - P. Ox. Hub | 0 | 1 | 0 | 1 | 3 | 0 | 1 | 5
LP5951MG-1.8/NOPB - Voltage Regulator | 0 | 1 | 0 | 1 | 3 | 0 | 3 | 3
BME280 - Temp Sensor | 0 | 0 | 1 | 1 | 3 | 0 | 3 | 3
Misc.
USB Connnector | 1 | 0 | 0 | 1 | 3 | 0 | 2 | 4
Switches | 1 | 0 | 0 | 1 | 3 | 0 | Many | 0
2.2 uH 0805 Inductor | 1 | 1 | 0 | 2 | 6 | 0 | 1 | 8
AS11AH Switch | 1 | 0 | 0 | 1 | 3 | 0 | 2 | 4
8.0 MHz Resonator | 1 | 0 | 0 | 1 | 3 | 0 | 4 | 2
ABS07W32 - Crystal Oscillator | 0 | 1 | 0 | 1 | 3 | 0 | 3 | 3

Sheet: Sheet1
RECEIVING
DATE | ITEM | QUANTITY
2021-05-12 | 621-AP7365-WG-7 | 7
