PwndaThePwner/Hydration/documents/Soldering_Rework.docx

SOLDERING REWORK

FVM

- Neo-M8

IAPO

- U8: MAX32664GTGA+T - P. Ox. Hub
- U4/U3: ADG849 Switch
