PwndaThePwner/Hydration/FEMAVitalsMonitor/BodyTempSensor/BodyTempSensor.kicad_pcb

## KiCad design FEMAVitalsMonitor/BodyTempSensor/BodyTempSensor.kicad_pcb (2021-05-06)

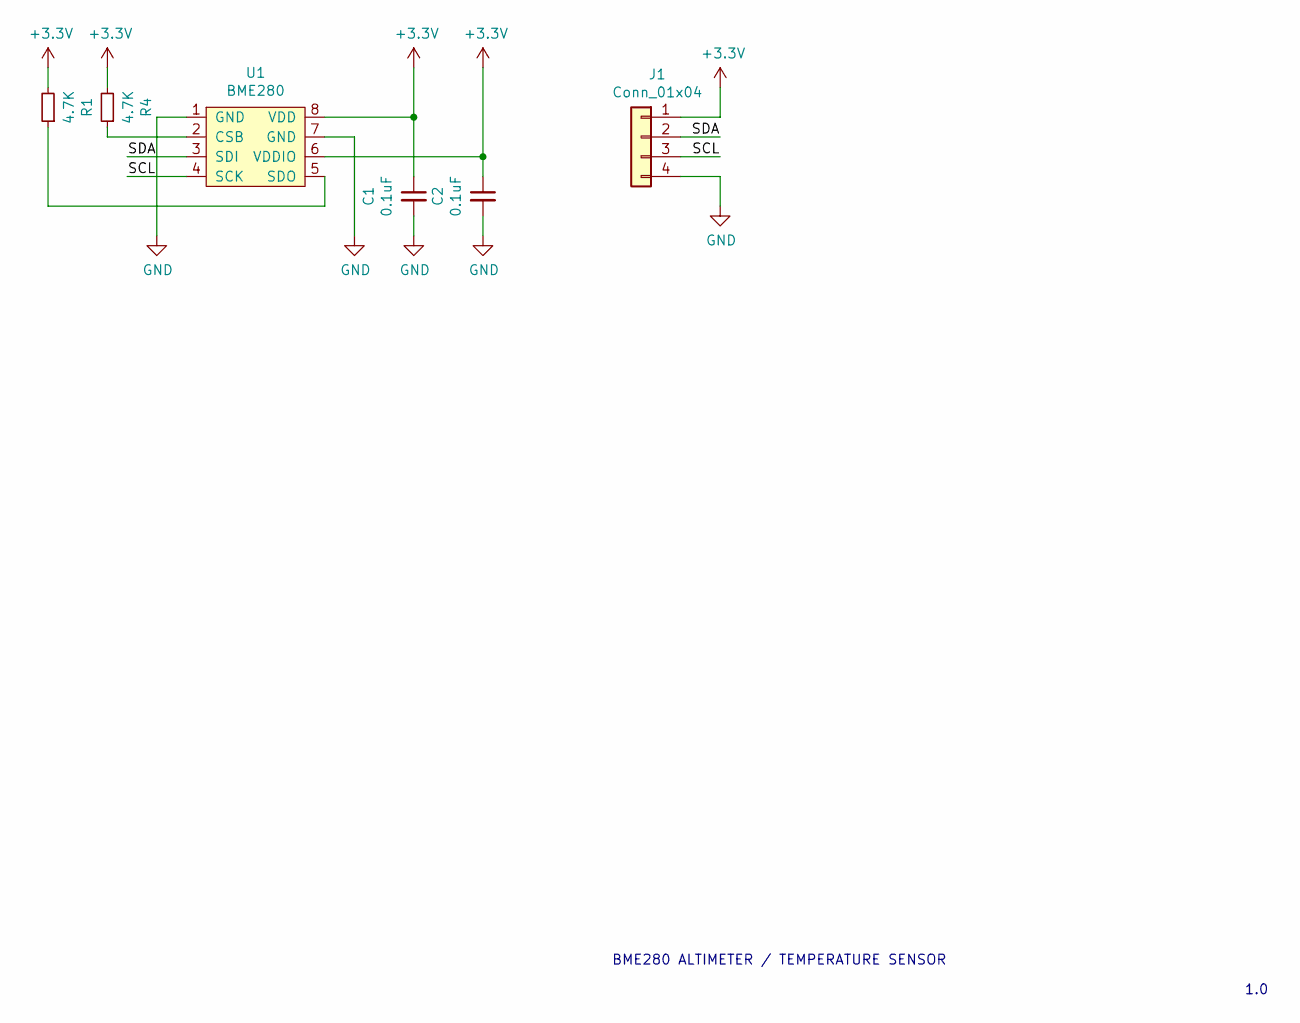
[picture p1: schematic BodyTempSensor.sch]

Parts:
C1, C2: 0.1uF; C_0805_2012Metric_Pad1.18x1.45mm_HandSolder
J1: Conn_01x04; PinHeader_1x04_P2.54mm_Vertical
R1, R4: 4.7K; R_0805_2012Metric_Pad1.20x1.40mm_HandSolder
U1: BME280; BMP280

Connections:
+3V3: C1.1, C2.1, J1.1, R1.2, R4.2, U1.6 (VDDIO), U1.8 (VDD)
/SCL: J1.3, U1.4 (SCK)
/SDA: J1.2, U1.3 (SDI)
GND: C1.2, C2.2, J1.4, U1.1 (GND), U1.7 (GND)
unnamed: R1.1, U1.5 (SDO)
unnamed: R4.1, U1.2 (CSB)

Notes on the sheet:
BME280 ALTIMETER / TEMPERATURE SENSOR
1.0

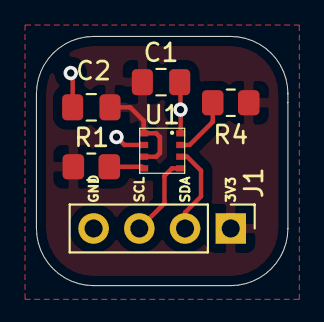
[picture p2: board BodyTempSensor.kicad_pcb from above]

Board: 2 copper layers, 14.0 x 13.8 mm, 6 parts (0 on the bottom side), 6 nets.
