PwndaThePwner/Hydration/FEMAVitalsMonitor/FEMAVitalsMonitor.kicad_pcb

## KiCad design FEMAVitalsMonitor/FEMAVitalsMonitor.kicad_pcb (2021-05-06)

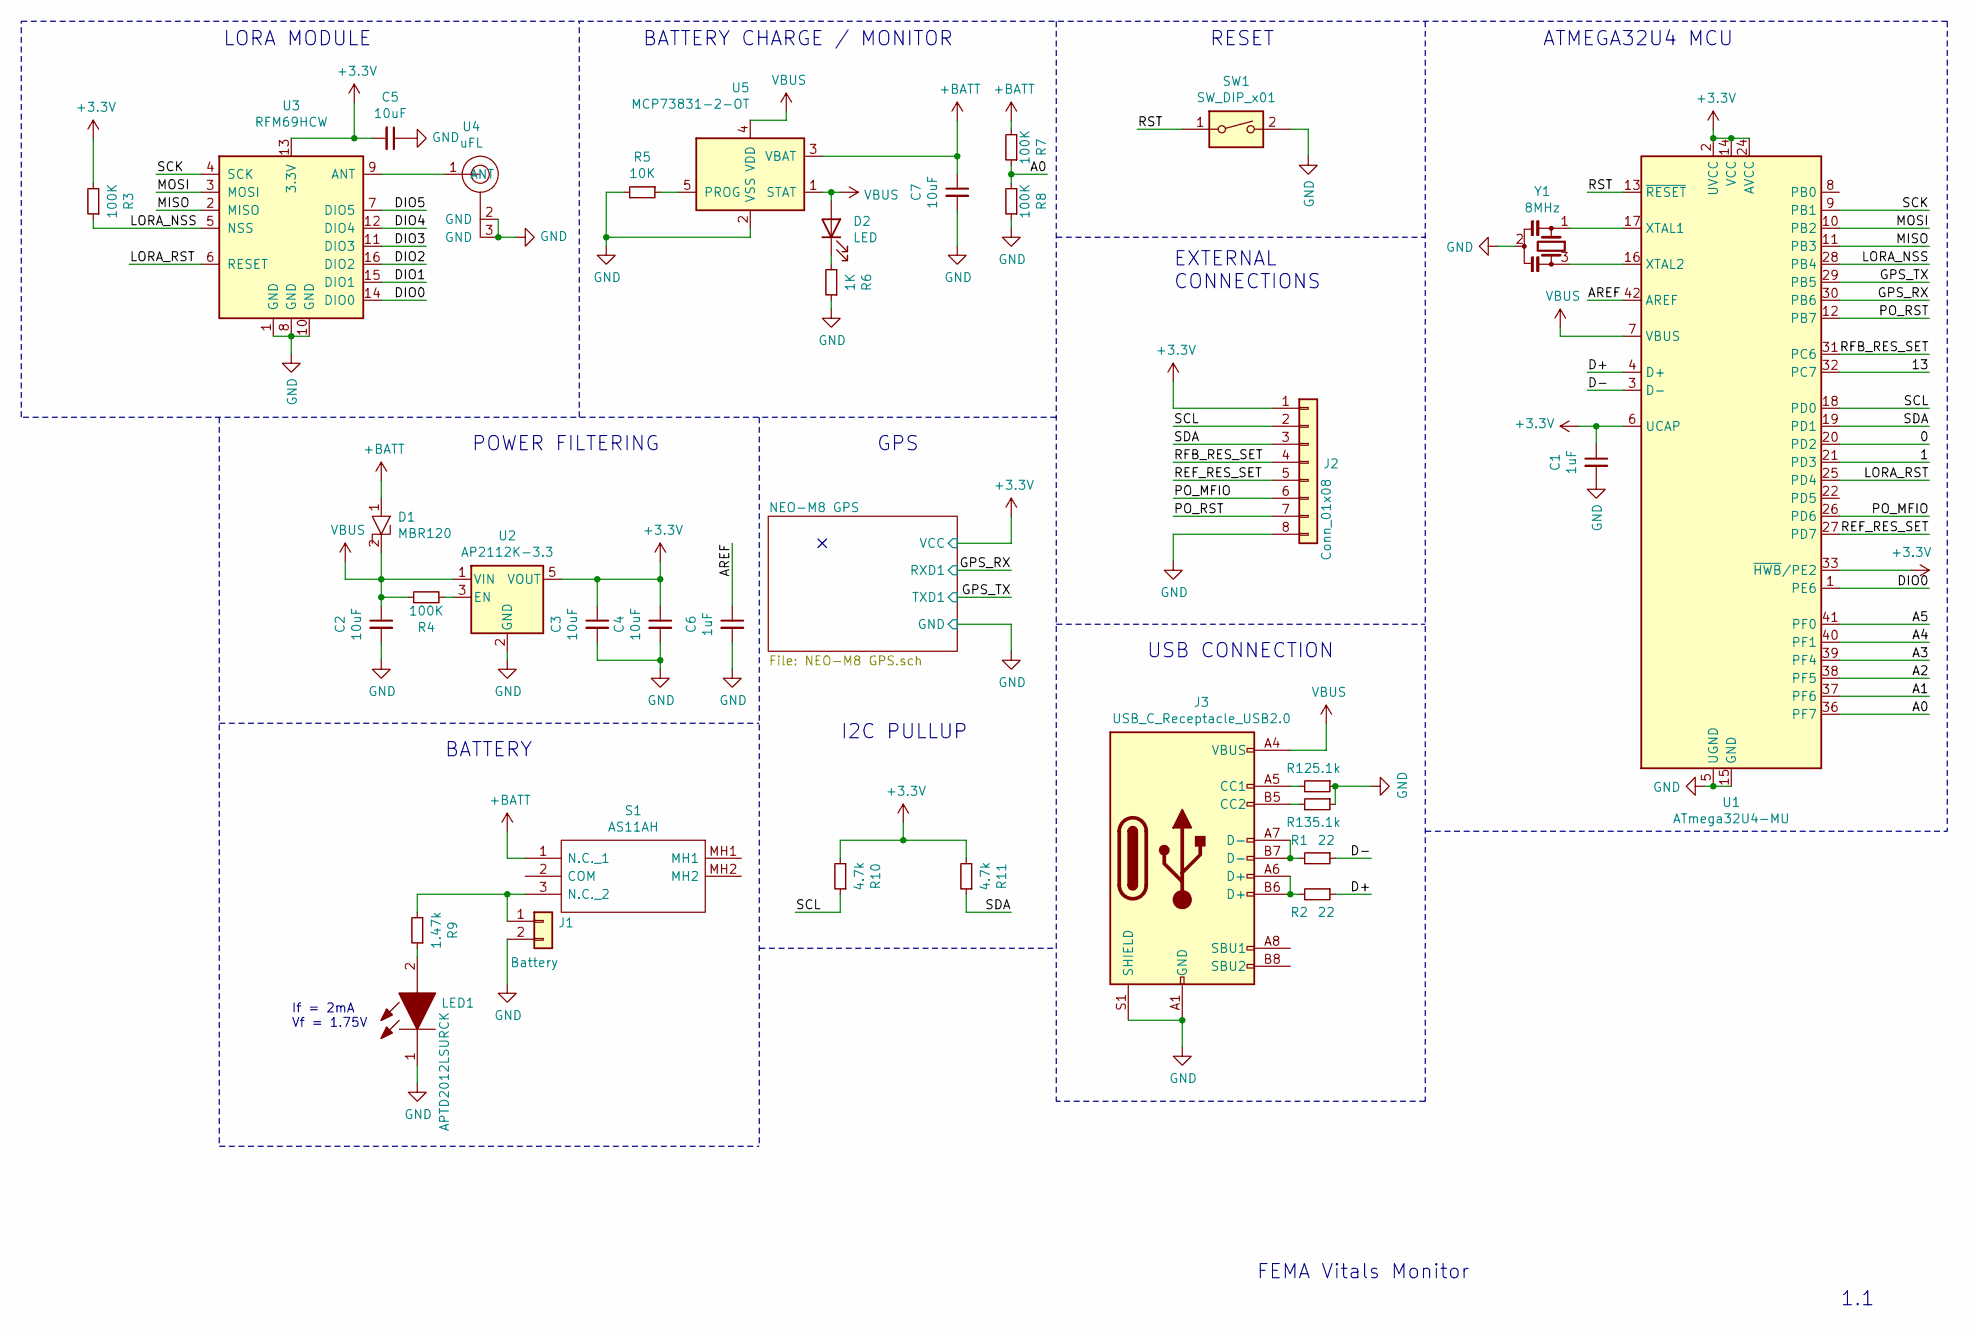
[picture p3: schematic FEMAVitalsMonitor.sch]

Parts:
C1, C6: 1uF; C_0805_2012Metric_Pad1.18x1.45mm_HandSolder
C2, C3, C4, C5, C7: 10uF; C_0805_2012Metric_Pad1.18x1.45mm_HandSolder
D1: MBR120; D_SOD-123F
D2: LED; LED_1206_3216Metric_Pad1.42x1.75mm_HandSolder
J1: Battery; PinHeader_1x02_P2.54mm_Vertical
J2: Conn_01x08; PinHeader_1x08_P2.54mm_Vertical
J3: USB_C_Receptacle_USB2.0; USB_C_Receptacle_GCT_USB4085
LED1: APTD2012LSURCK; LEDM2012X120N; Mouser Part Number 604-APTD2012LSURCK
R1, R2: 22; R_2010_5025Metric_Pad1.40x2.65mm_HandSolder
R3, R4, R7, R8: 100K; R_0805_2012Metric_Pad1.20x1.40mm_HandSolder
R5: 10K; R_0805_2012Metric_Pad1.20x1.40mm_HandSolder
R6: 1K; R_0805_2012Metric_Pad1.20x1.40mm_HandSolder
R9: 1.47k; R_0805_2012Metric_Pad1.20x1.40mm_HandSolder
R10, R11: 4.7k; R_0805_2012Metric_Pad1.20x1.40mm_HandSolder
R12, R13: 5.1k; R_0805_2012Metric_Pad1.20x1.40mm_HandSolder
S1: AS11AH; AS13AH; Mouser Part Number 633-AS11AH
SW1: SW_DIP_x01; SW_PUSH_6mm_H7.3mm
U1: ATmega32U4-MU; QFN-44-1EP_7x7mm_P0.5mm_EP5.2x5.2mm
U2: AP2112K-3.3; SOT-23-5
U3: RFM69HCW
U4: uFL; U.FL_Hirose_U.FL-R-SMT-1_Vertical
U5: MCP73831-2-OT; SOT-23-5
Y1: 8MHz; AWSCR800CELBC10T3

Connections:
+3V3: C1.1, C3.1, C4.1, C5.2, J2.1, R3.2, R10.2, R11.2, U1.2 (UVCC), U1.6 (UCAP), U1.14 (VCC), U1.24 (AVCC), U1.33 (~HWB~/PE2), U1.34 (VCC), U1.44 (AVCC), U2.5 (VOUT), U3.13 (3.3V); also elsewhere on the board
+BATT: C7.1, D1.1, R7.2, S1.1 (N.C._1), U5.3 (VBAT)
/0: U1.20 (PD2)
/1: U1.21 (PD3)
/13: U1.32 (PC7)
/A0: R7.1, R8.2, U1.36 (PF7)
/A1: U1.37 (PF6)
/A2: U1.38 (PF5)
/A3: U1.39 (PF4)
/A4: U1.40 (PF1)
/A5: U1.41 (PF0)
/AREF: C6.1, U1.42 (AREF)
/D+: R2.1, U1.4 (D+)
/D-: R1.1, U1.3 (D-)
/DIO0: U1.1 (PE6), U3.14 (DIO0)
/DIO1: U3.15 (DIO1)
/DIO2: U3.16 (DIO2)
/DIO3: U3.11 (DIO3)
/DIO4: U3.12 (DIO4)
/DIO5: U3.7 (DIO5)
/GPS_RX: U1.30 (PB6); also elsewhere on the board
/GPS_TX: U1.29 (PB5); also elsewhere on the board
/LORA_NSS: R3.1, U1.28 (PB4), U3.5 (NSS)
/LORA_RST: U1.25 (PD4), U3.6 (RESET)
/MISO: U1.11 (PB3), U3.2 (MISO)
/MOSI: U1.10 (PB2), U3.3 (MOSI)
/PO_MFIO: J2.6, U1.26 (PD6)
/PO_RST: J2.7, U1.12 (PB7)
/REF_RES_SET: J2.5, U1.27 (PD7)
/RFB_RES_SET: J2.4, U1.31 (PC6)
/RST: SW1.1, U1.13 (~RESET)
/SCK: U1.9 (PB1), U3.4 (SCK)
/SCL: J2.2, R10.1, U1.18 (PD0)
/SDA: J2.3, R11.1, U1.19 (PD1)
GND: C1.2, C2.2, C3.2, C4.2, C5.1, C6.2, C7.2, J1.2, J2.8, J3.A1 (GND), J3.A12 (GND), J3.B1 (GND), J3.B12 (GND), J3.S1 (SHIELD), LED1.1, R5.2, R6.1, R8.1, R12.1, R13.1, SW1.2, U1.5 (UGND), U1.15 (GND), U1.23 (GND), U1.35 (GND), U1.43 (GND), U1.45 (GND), U2.2 (GND), U3.1 (GND), U3.8 (GND), U3.10 (GND), U4.2 (GND), U4.3 (GND), U5.2 (VSS), Y1.2; also elsewhere on the board
unnamed: D2.1 (K), R6.2
unnamed: J1.1, R9.2, S1.3 (N.C._2)
unnamed: J3.A5 (CC1), R12.2
unnamed: J3.A6 (D+), J3.B6 (D+), R2.2
unnamed: J3.A7 (D-), J3.B7 (D-), R1.2
unnamed: J3.B5 (CC2), R13.2
unnamed: LED1.2, R9.1
unnamed: R4.2, U2.3 (EN)
unnamed: R5.1, U5.5 (PROG)
unnamed: U1.16 (XTAL2), Y1.3
unnamed: U1.17 (XTAL1), Y1.1
unnamed: U3.9 (ANT), U4.1 (ANT)
VBUS: C2.1, D1.2, D2.2 (A), J3.A4 (VBUS), J3.A9 (VBUS), J3.B4 (VBUS), J3.B9 (VBUS), R4.1, U1.7 (VBUS), U2.1 (VIN), U5.1 (STAT), U5.4 (VDD)

Notes on the sheet:
LORA MODULE
BATTERY CHARGE / MONITOR
POWER FILTERING
FEMA Vitals Monitor
1.1
ATMEGA32U4 MCU
RESET
GPS
EXTERNAL CONNECTIONS
USB CONNECTION
I2C PULLUP
If = 2mA Vf = 1.75V
BATTERY

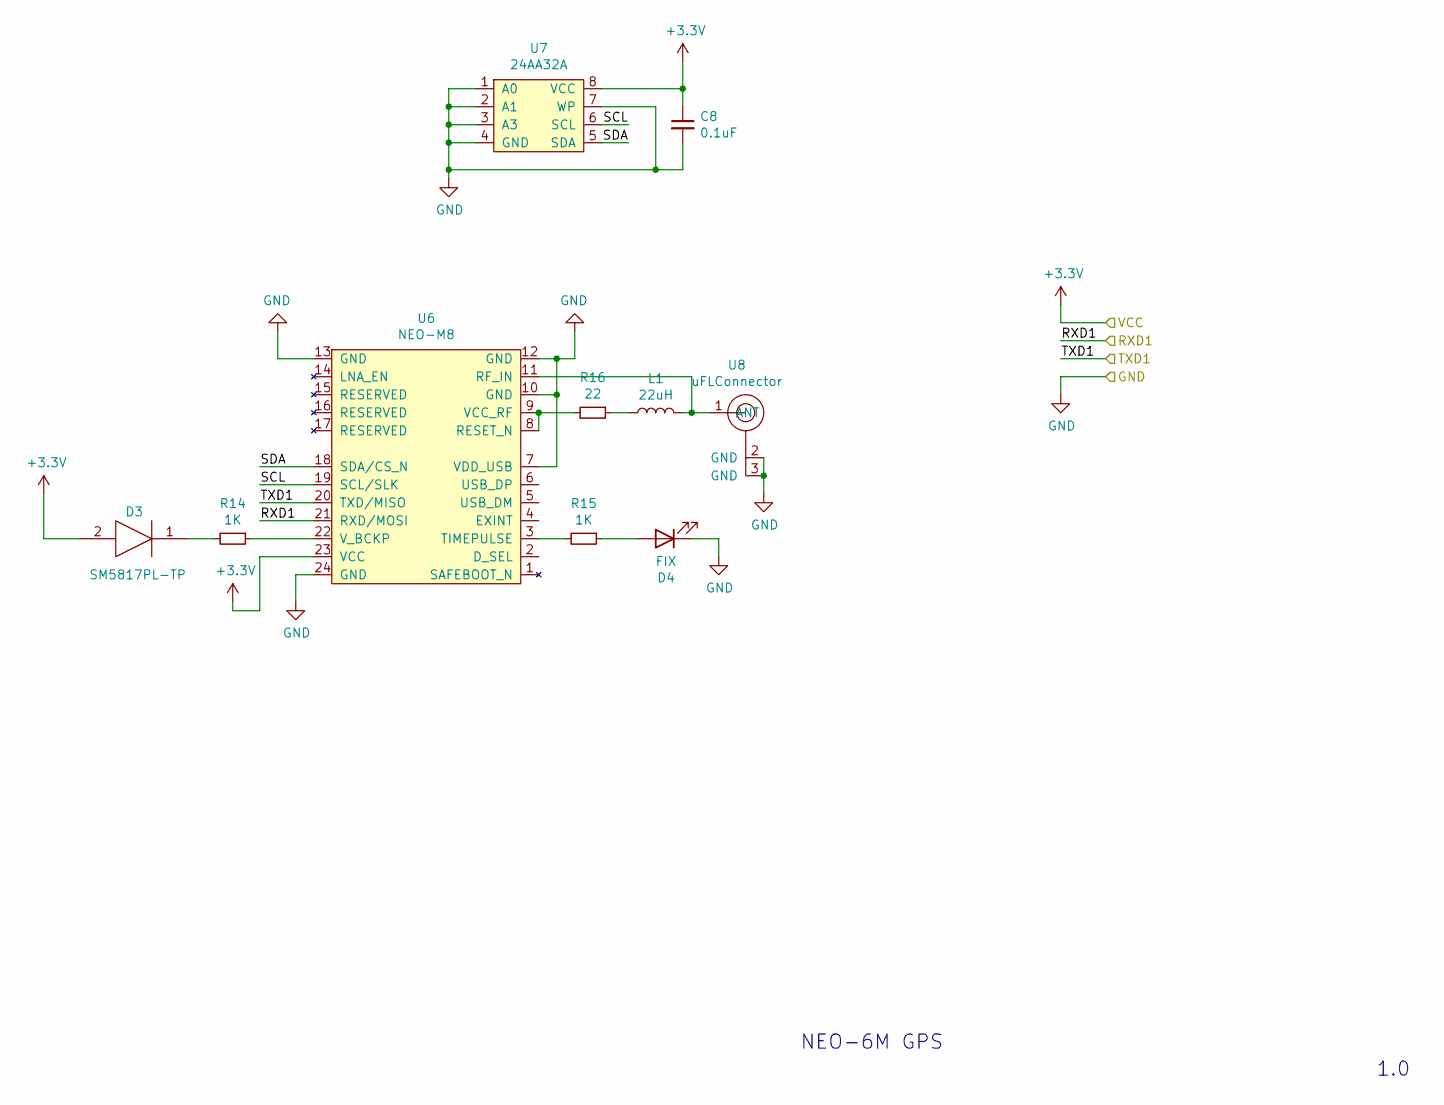
[picture p4: schematic NEO-M8 GPS.sch]

Parts:
C8: 0.1uF; C_0805_2012Metric_Pad1.18x1.45mm_HandSolder
D3: SM5817PL-TP; SOD3716X120N; Mouser Part Number 833-SM5817PL-TP
D4: FIX; LED_0805_2012Metric_Pad1.15x1.40mm_HandSolder
L1: 22uH; L_0805_2012Metric_Pad1.15x1.40mm_HandSolder
R14, R15: 1K; R_0805_2012Metric_Pad1.20x1.40mm_HandSolder
R16: 22; R_0805_2012Metric_Pad1.20x1.40mm_HandSolder
U6: NEO-M8; ublox_NEO
U7: 24AA32A; SOIJ-8_5.3x5.3mm_P1.27mm
U8: uFLConnector; U.FL_Hirose_U.FL-R-SMT-1_Vertical

Connections:
+3V3: C8.1, D3.2, U6.23 (VCC), U7.8 (VCC); also elsewhere on the board
/GPS_RX: U6.21 (RXD/MOSI); also elsewhere on the board
/GPS_TX: U6.20 (TXD/MISO); also elsewhere on the board
/NEO-M8 GPS/SCL: U6.19 (SCL/SLK), U7.6 (SCL)
/NEO-M8 GPS/SDA: U6.18 (SDA/CS_N), U7.5 (SDA)
GND: C8.2, D4.1 (K), U6.7 (VDD_USB), U6.10 (GND), U6.12 (GND), U6.13 (GND), U6.24 (GND), U7.1 (A0), U7.2 (A1), U7.3 (A3), U7.4 (GND), U7.7 (WP), U8.2 (GND), U8.3 (GND); also elsewhere on the board
unnamed: D3.1, R14.2
unnamed: D4.2 (A), R15.1
unnamed: L1.1, R16.1
unnamed: L1.2, U6.11 (RF_IN), U8.1 (ANT)
unnamed: R14.1, U6.22 (V_BCKP)
unnamed: R15.2, U6.3 (TIMEPULSE)
unnamed: R16.2, U6.8 (RESET_N), U6.9 (VCC_RF)

Notes on the sheet:
NEO-6M GPS
1.0

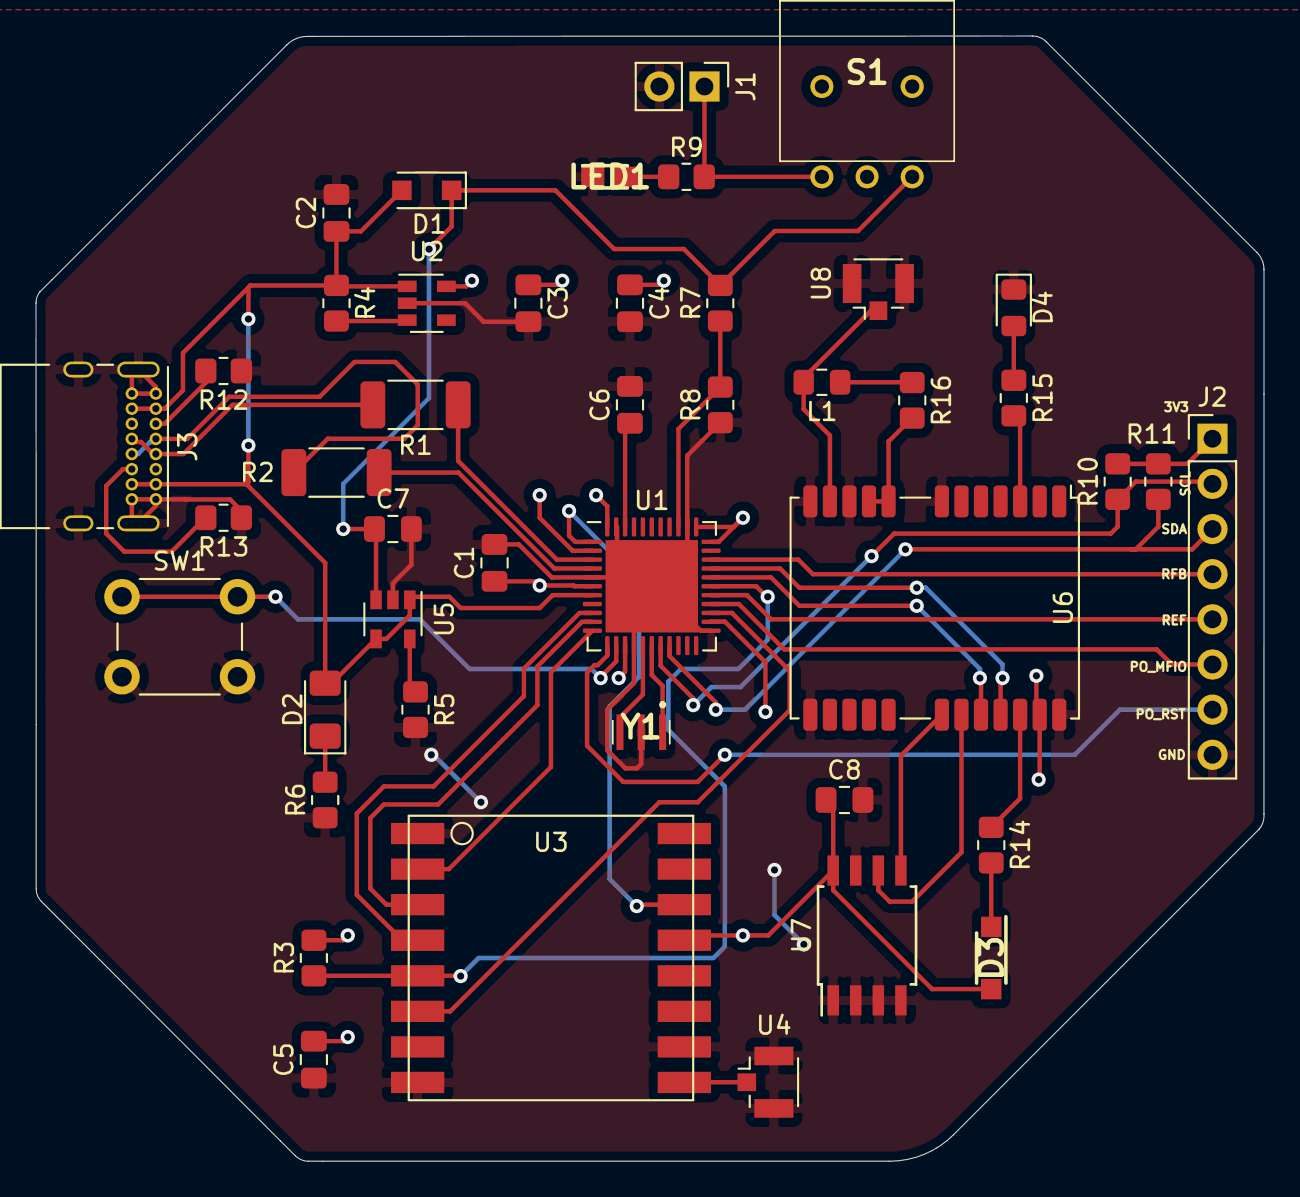
[picture p5: board FEMAVitalsMonitor.kicad_pcb from above]

Board: 2 copper layers, 69.1 x 63.3 mm, 44 parts (0 on the bottom side), 44 nets.
