PwndaThePwner/Hydration/FEMAVitalsMonitor/ImpedanceAnalyzerPulseOximeter/ImpedanceAnalyzerPulseOximeter.kicad_pcb

## KiCad design FEMAVitalsMonitor/ImpedanceAnalyzerPulseOximeter/ImpedanceAnalyzerPulseOximeter.kicad_pcb (2021-05-06)

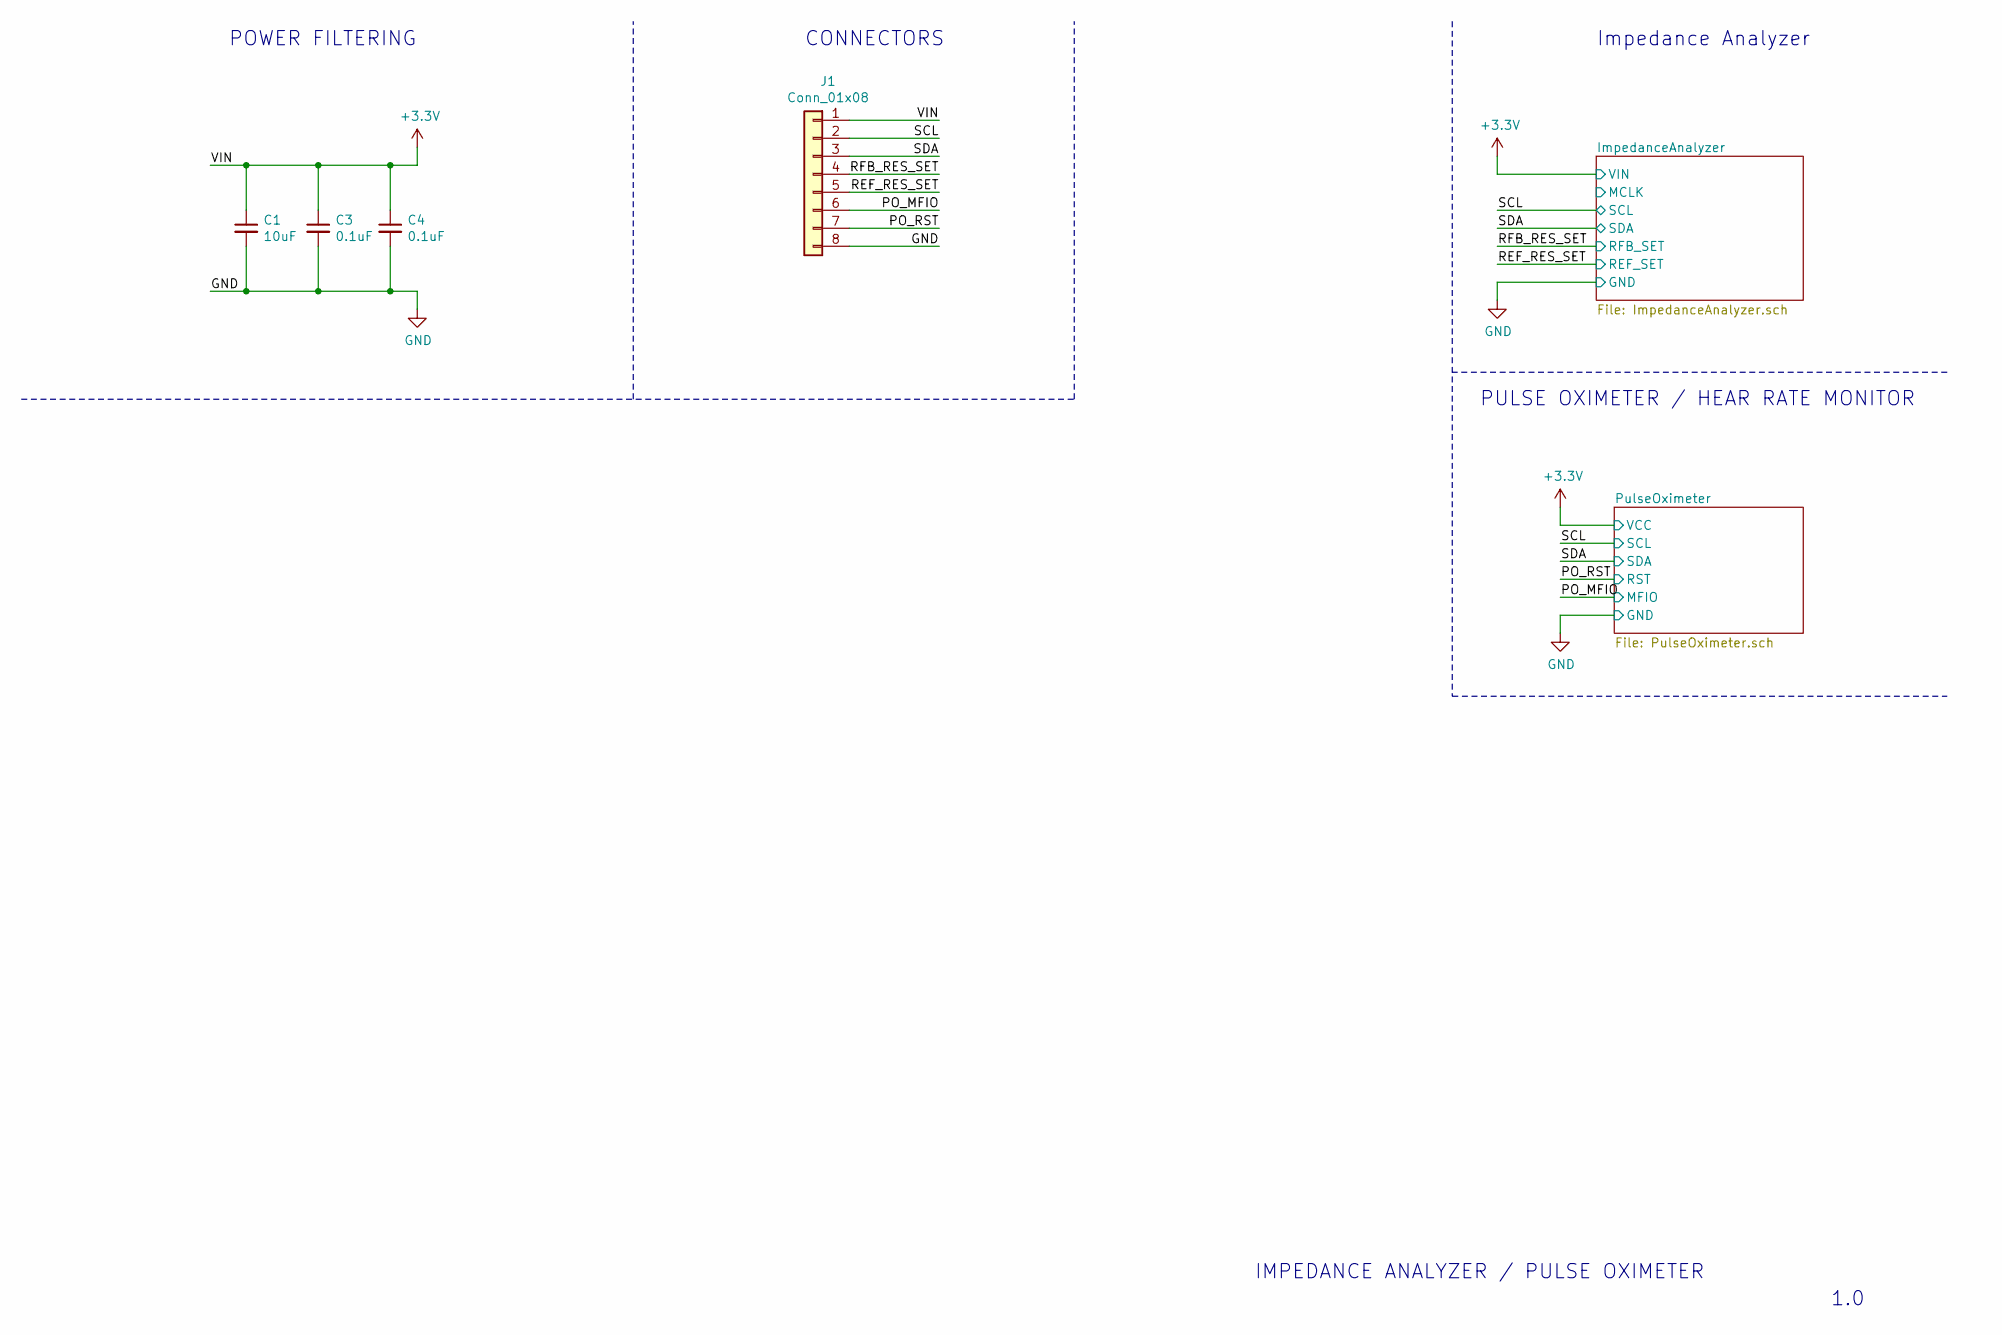
[picture p6: schematic ImpedanceAnalyzerPulseOximeter.sch]

Parts:
C1: 10uF; C_0805_2012Metric_Pad1.18x1.45mm_HandSolder
C3, C4: 0.1uF; C_0805_2012Metric_Pad1.18x1.45mm_HandSolder
J1: Conn_01x08; PinHeader_1x08_P2.54mm_Vertical

Connections:
+3V3: C1.1, C3.1, C4.1, J1.1; also elsewhere on the board
/PO_MFIO: J1.6; also elsewhere on the board
/PO_RST: J1.7; also elsewhere on the board
/REF_RES_SET: J1.5; also elsewhere on the board
/RFB_RES_SET: J1.4; also elsewhere on the board
/SCL: J1.2; also elsewhere on the board
/SDA: J1.3; also elsewhere on the board
GND: C1.2, C3.2, C4.2, J1.8; also elsewhere on the board

Notes on the sheet:
Impedance Analyzer
POWER FILTERING
PULSE OXIMETER / HEAR RATE MONITOR
CONNECTORS
IMPEDANCE ANALYZER / PULSE OXIMETER
1.0

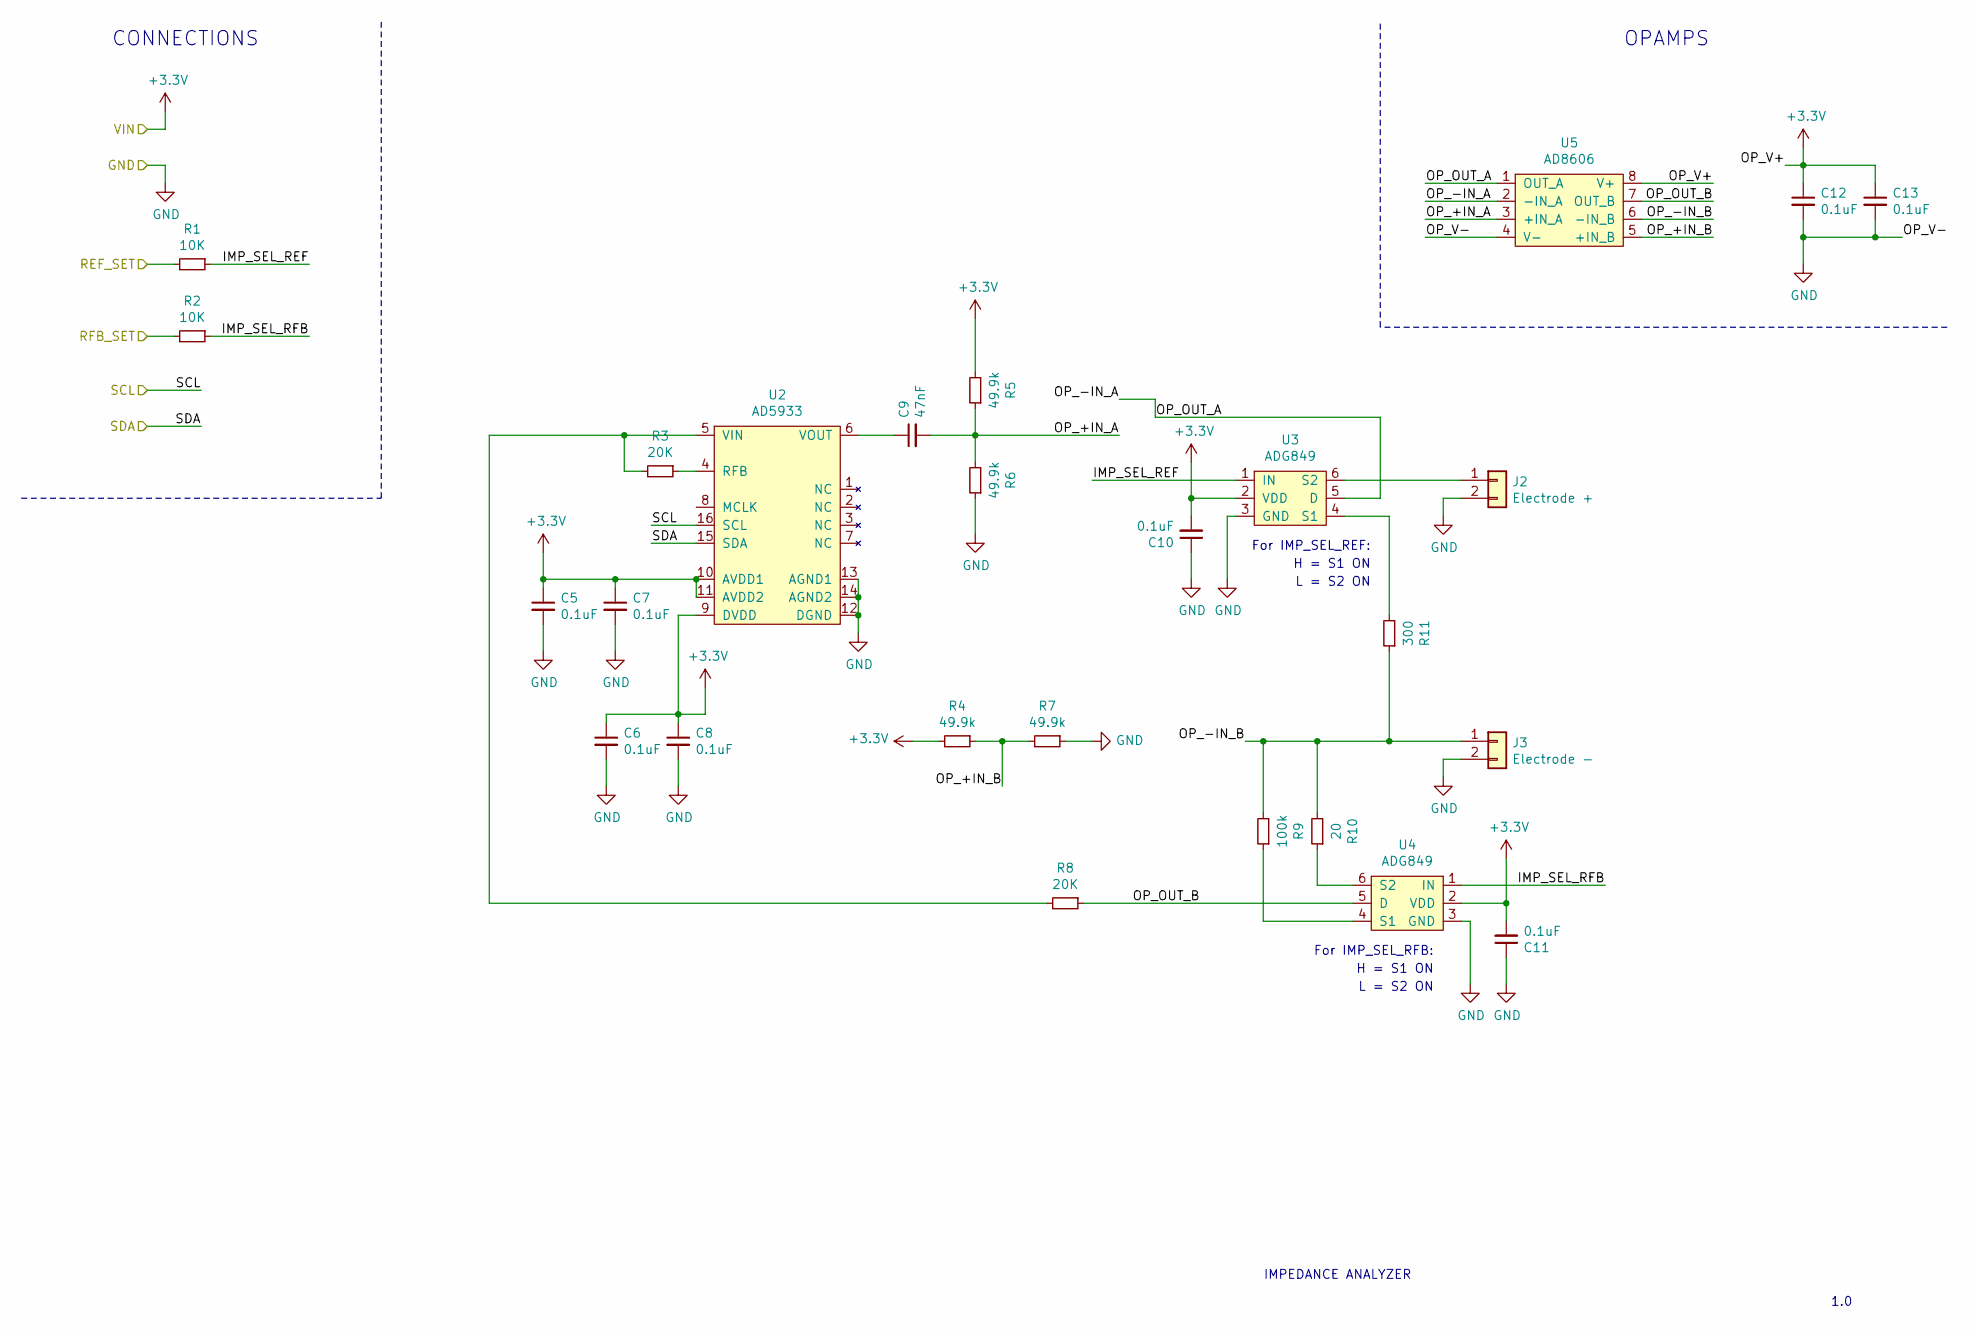
[picture p7: schematic ImpedanceAnalyzer.sch]

Parts:
C5, C6, C7, C8, C10, C11, C12, C13: 0.1uF; C_0805_2012Metric_Pad1.18x1.45mm_HandSolder
C9: 47nF; C_0805_2012Metric_Pad1.18x1.45mm_HandSolder
J2: Electrode +; PinHeader_1x02_P2.54mm_Vertical
J3: Electrode -; PinHeader_1x02_P2.54mm_Vertical
R1, R2: 10K; R_0805_2012Metric_Pad1.20x1.40mm_HandSolder
R3, R8: 20K; R_0805_2012Metric_Pad1.20x1.40mm_HandSolder
R4, R5, R6, R7: 49.9k; R_0805_2012Metric_Pad1.20x1.40mm_HandSolder
R9: 100k; R_0805_2012Metric_Pad1.20x1.40mm_HandSolder
R10: 20; R_2010_5025Metric_Pad1.40x2.65mm_HandSolder
R11: 300; R_0805_2012Metric_Pad1.20x1.40mm_HandSolder
U2: AD5933; SSOP-16_5.3x6.2mm_P0.65mm
U3, U4: ADG849
U5: AD8606; MSOP-8_3x3mm_P0.65mm

Connections:
+3V3: C5.1, C6.1, C7.1, C8.1, C10.2, C11.2, C12.1, C13.1, R4.2, R5.2, U2.9 (DVDD), U2.10 (AVDD1), U2.11 (AVDD2), U3.2 (VDD), U4.2 (VDD), U5.8 (V+); also elsewhere on the board
/ImpedanceAnalyzer/IMP_SEL_REF: R1.1, U3.1 (IN)
/ImpedanceAnalyzer/IMP_SEL_RFB: R2.1, U4.1 (IN)
/ImpedanceAnalyzer/OP_+IN_A: C9.2, R5.1, R6.2, U5.3 (+IN_A)
/ImpedanceAnalyzer/OP_+IN_B: R4.1, R7.2, U5.5 (+IN_B)
/ImpedanceAnalyzer/OP_-IN_A: U3.5 (D), U5.1 (OUT_A), U5.2 (-IN_A)
/ImpedanceAnalyzer/OP_-IN_B: J3.1, R9.2, R10.2, R11.1, U5.6 (-IN_B)
/ImpedanceAnalyzer/OP_OUT_B: R8.1, U4.5 (D), U5.7 (OUT_B)
/REF_RES_SET: R1.2; also elsewhere on the board
/RFB_RES_SET: R2.2; also elsewhere on the board
/SCL: U2.16 (SCL); also elsewhere on the board
/SDA: U2.15 (SDA); also elsewhere on the board
GND: C5.2, C6.2, C7.2, C8.2, C10.1, C11.1, C12.2, C13.2, J2.2, J3.2, R6.1, R7.1, U2.12 (DGND), U2.13 (AGND1), U2.14 (AGND2), U3.3 (GND), U4.3 (GND), U5.4 (V-); also elsewhere on the board
unnamed: C9.1, U2.6 (VOUT)
unnamed: J2.1, U3.6 (S2)
unnamed: R3.1, U2.4 (RFB)
unnamed: R3.2, R8.2, U2.5 (VIN)
unnamed: R9.1, U4.4 (S1)
unnamed: R10.1, U4.6 (S2)
unnamed: R11.2, U3.4 (S1)

Notes on the sheet:
For IMP_SEL_REF:
H = S1 ON
L = S2 ON
For IMP_SEL_RFB:
OPAMPS
CONNECTIONS
IMPEDANCE ANALYZER
1.0

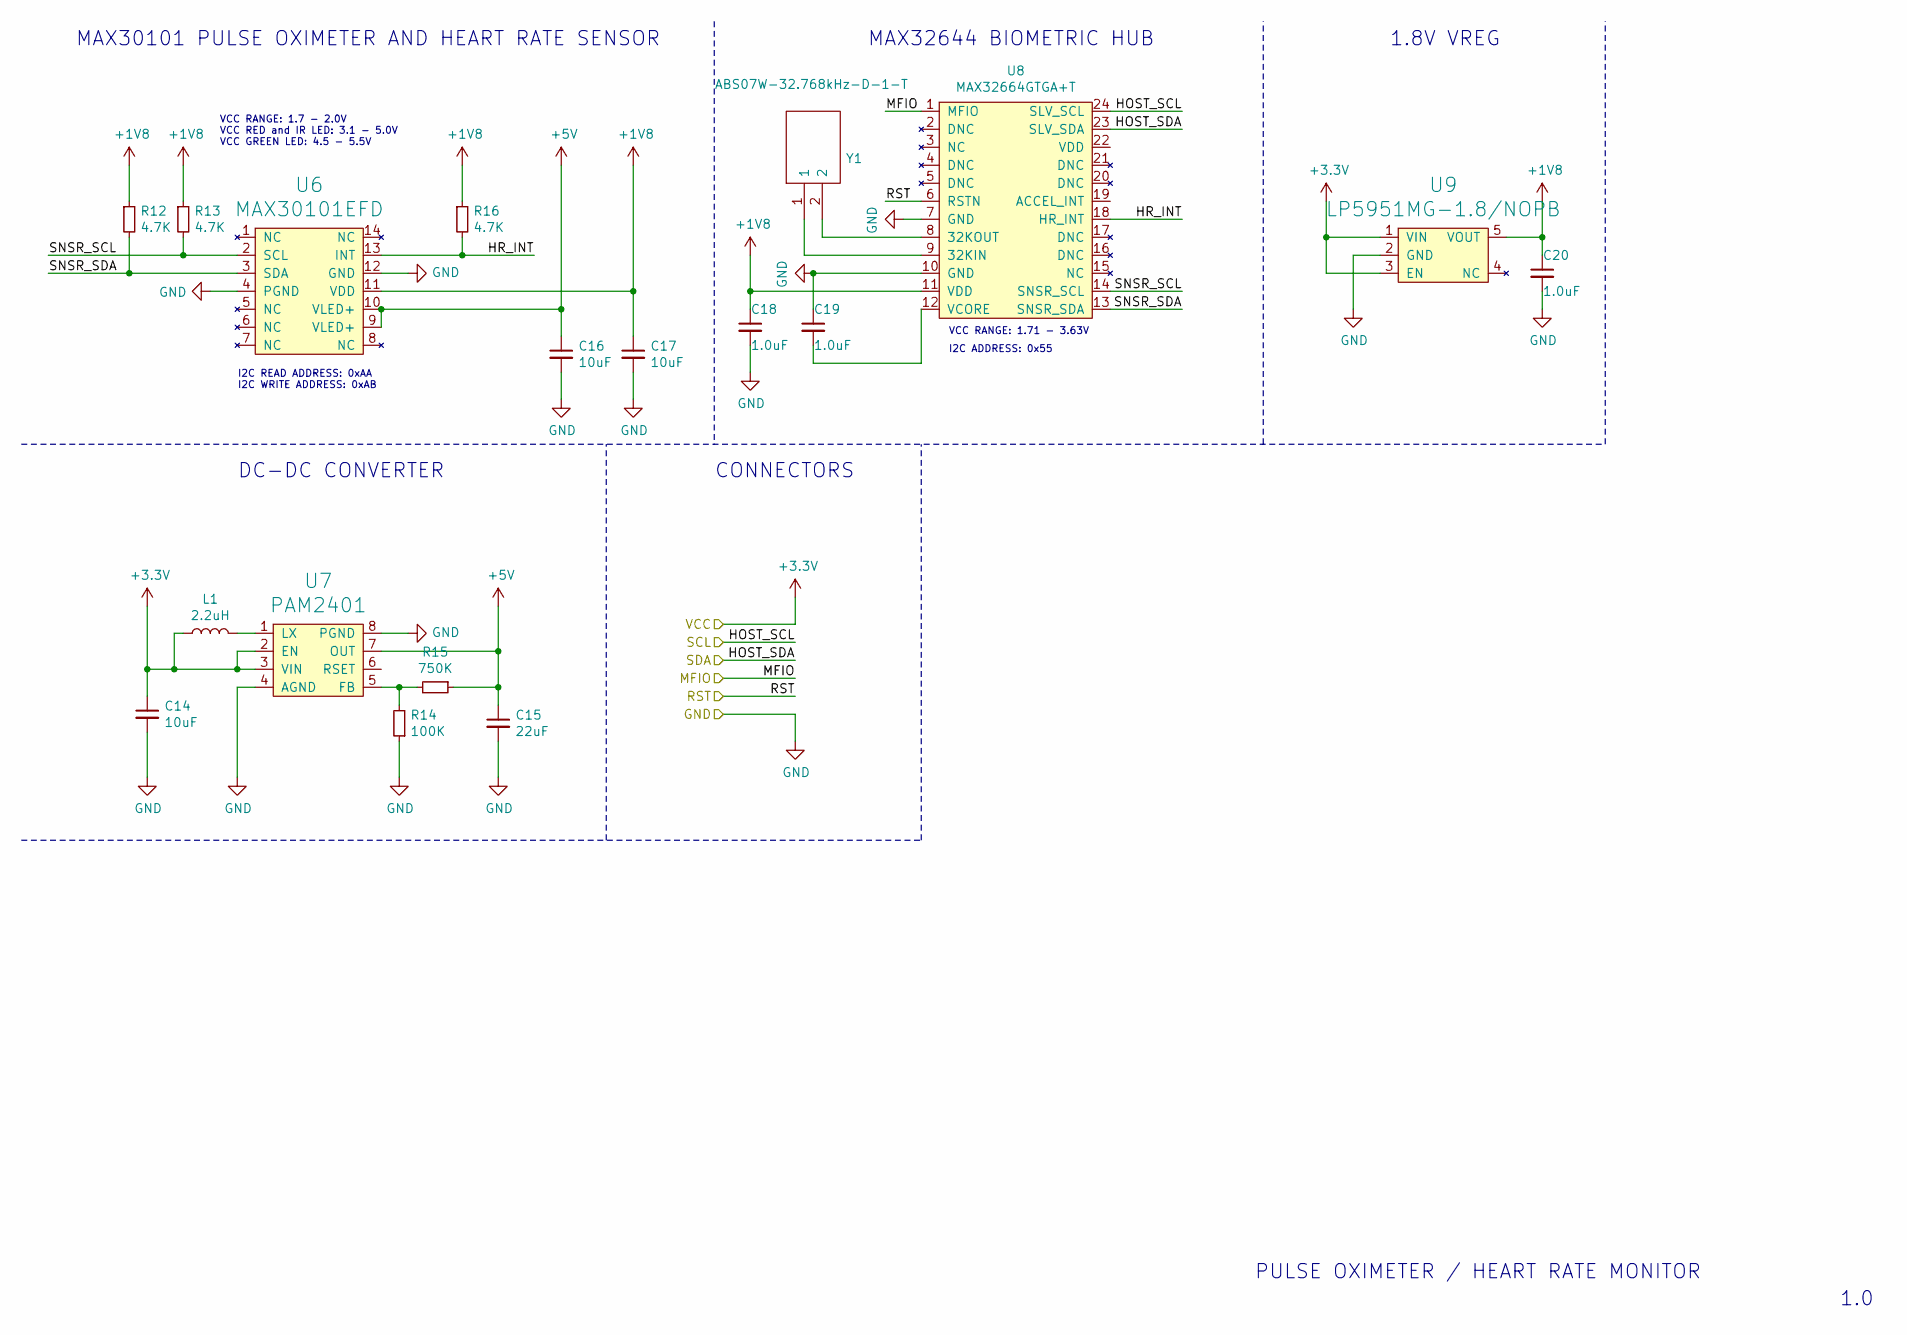
[picture p8: schematic PulseOximeter.sch]

Parts:
C14, C16, C17: 10uF; C_0805_2012Metric_Pad1.18x1.45mm_HandSolder
C15: 22uF; C_0805_2012Metric_Pad1.18x1.45mm_HandSolder
C18, C19, C20: 1.0uF; C_0805_2012Metric_Pad1.18x1.45mm_HandSolder
L1: 2.2uH; L_0805_2012Metric_Pad1.15x1.40mm_HandSolder
R12, R13, R16: 4.7K; R_0805_2012Metric_Pad1.20x1.40mm_HandSolder
R14: 100K; R_0805_2012Metric_Pad1.20x1.40mm_HandSolder
R15: 750K; R_0805_2012Metric_Pad1.20x1.40mm_HandSolder
U6: MAX30101EFD; 14-LEAD-OESIP
U7: PAM2401; MSOP-8_3x3mm_P0.65mm
U8: MAX32664GTGA+T; MAX32664GTGA&plus_T
U9: LP5951MG-1.8/NOPB; SOT-353_SC-70-5_Handsoldering
Y1: ABS07W-32.768kHz-D-1-T; ABS07AIG32768kHz71T; Mouser Part Number 815-ABS07W32.768KD1T

Connections:
+1V8: C17.1, C18.1, C20.1, R12.1, R13.1, R16.1, U6.11 (VDD), U8.11 (VDD), U9.5 (VOUT)
+3V3: C14.1, L1.1, U7.2 (EN), U7.3 (VIN), U9.1 (VIN), U9.3 (EN); also elsewhere on the board
+5V: C15.1, C16.1, R15.1, U6.9 (VLED+), U6.10 (VLED+), U7.7 (OUT)
/PO_MFIO: U8.1 (MFIO); also elsewhere on the board
/PO_RST: U8.6 (RSTN); also elsewhere on the board
/PulseOximeter/HR_INT: R16.2, U6.13 (INT), U8.18 (HR_INT)
/PulseOximeter/SNSR_SCL: R13.2, U6.2 (SCL), U8.14 (SNSR_SCL)
/PulseOximeter/SNSR_SDA: R12.2, U6.3 (SDA), U8.13 (SNSR_SDA)
/SCL: U8.24 (SLV_SCL); also elsewhere on the board
/SDA: U8.23 (SLV_SDA); also elsewhere on the board
GND: C14.2, C15.2, C16.2, C17.2, C18.2, C19.1, C20.2, R14.1, U6.4 (PGND), U6.12 (GND), U7.4 (AGND), U7.8 (PGND), U8.7 (GND), U8.10 (GND), U9.2 (GND); also elsewhere on the board
unnamed: C19.2, U8.12 (VCORE)
unnamed: L1.2, U7.1 (LX)
unnamed: R14.2, R15.2, U7.5 (FB)
unnamed: U8.8 (32KOUT), Y1.2
unnamed: U8.9 (32KIN), Y1.1

Notes on the sheet:
MAX30101 PULSE OXIMETER AND HEART RATE SENSOR
I2C READ ADDRESS: 0xAA I2C WRITE ADDRESS: 0xAB
VCC RANGE: 1.7 - 2.0V VCC RED and IR LED: 3.1 - 5.0V VCC GREEN LED: 4.5 - 5.5V
I2C ADDRESS: 0x55
VCC RANGE: 1.71 - 3.63V
MAX32644 BIOMETRIC HUB
1.8V VREG
DC-DC CONVERTER
CONNECTORS
PULSE OXIMETER / HEART RATE MONITOR
1.0

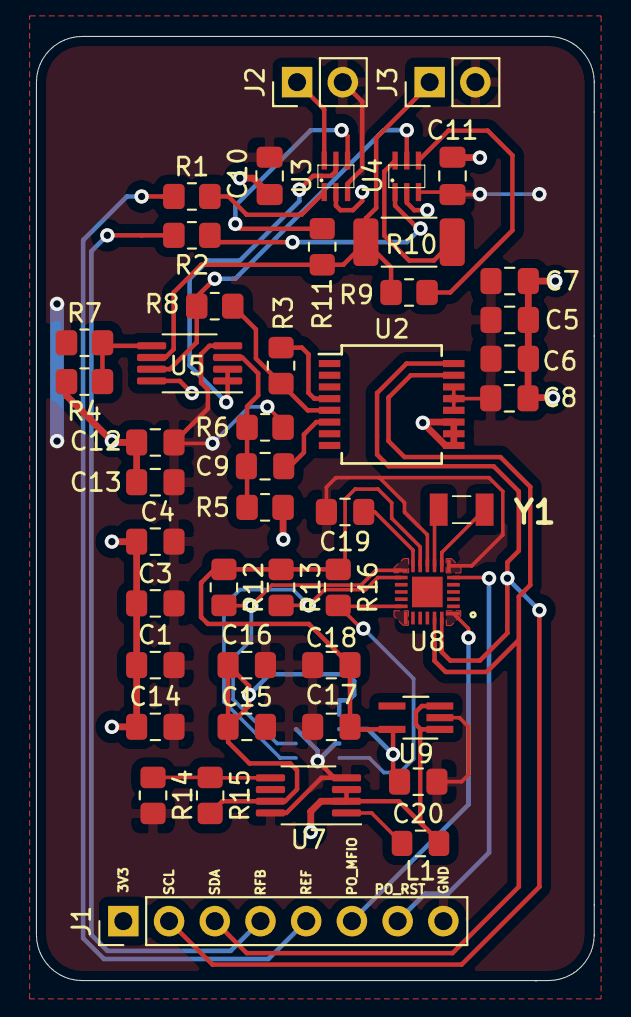
[picture p9: board ImpedanceAnalyzerPulseOximeter.kicad_pcb from above]

Board: 2 copper layers, 31.0 x 52.5 mm, 48 parts (1 on the bottom side), 32 nets.
