PwndaThePwner/Hydration/(commit log)

2021-02-27 inventory 2/26
    [Inventory.xlsx]
2021-03-02 Updated Inventory w/ PCB Inventories
    [Inventory.xlsx]
2021-03-02 update 3/2
    [Inventory.xlsx]
2021-03-02 updated w volt regulator missing on MCU PCB
    [Inventory.xlsx]
2021-03-04 3/4 Update
    [Inventory.xlsx]
2021-03-09 3/9 update
    [Inventory.xlsx]
2021-03-11 3/10 Update
    [Inventory.xlsx]
2021-03-11 PCB Design Projects 3/11/21
2021-03-15 3/15: no atmega32u4-MU yet
    [Inventory.xlsx]
2021-03-16 Battery Candidates 3/16
